ikerdcm/wulpus-pro_fpc/hw/wulpus_pro_fpc_board/wulpus_pro_acq_pcb/wulpus_pro_acq_pcb.kicad_pcb

## KiCad design hw/wulpus_pro_fpc_board/wulpus_pro_acq_pcb/wulpus_pro_acq_pcb.kicad_pcb (2026-04-16)

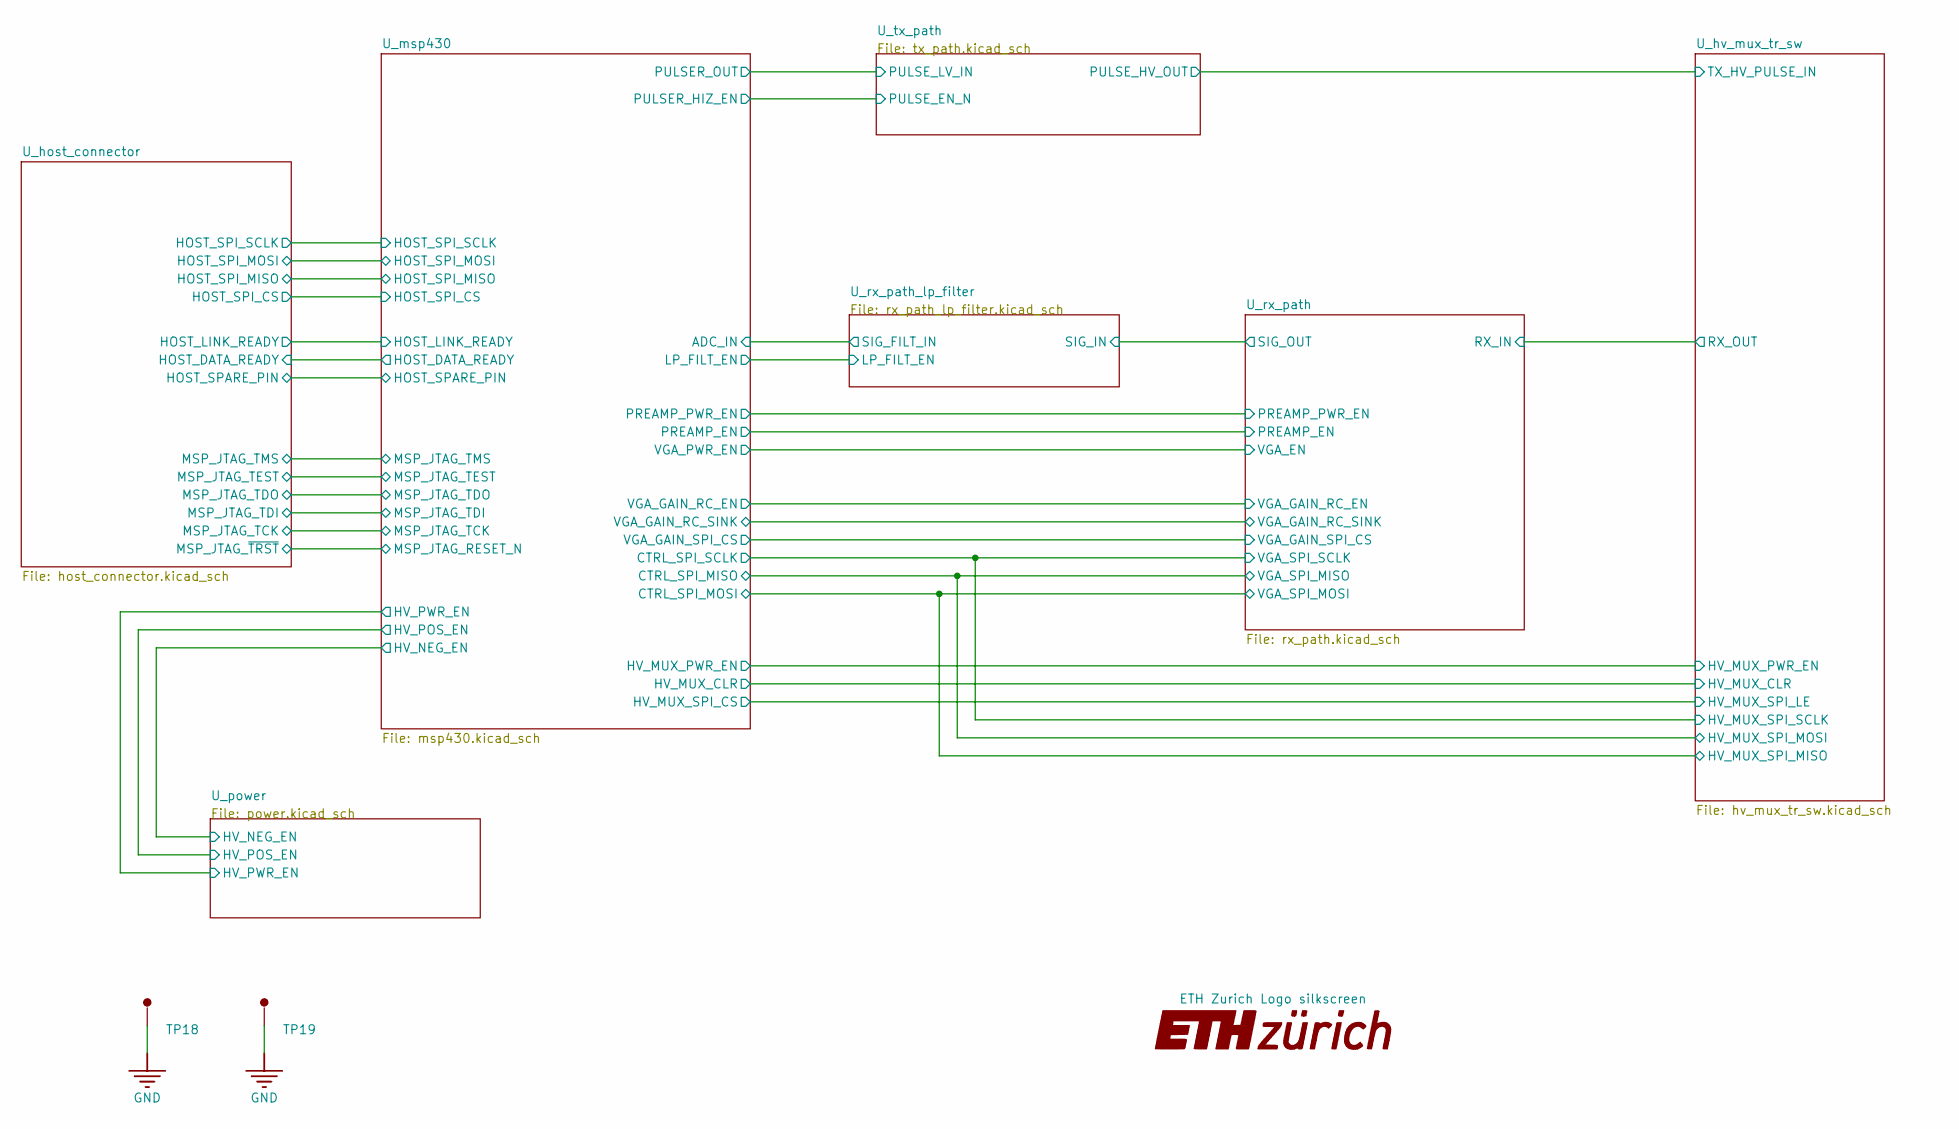
[picture p1: schematic wulpus_pro_acq_pcb.kicad_sch, WULPUS PRO Flex PCB]

Parts:
ART1: ETH Zurich Logo silkscreen; ETH_zurich_2mm
TP18, TP19: TP-SM-C-100; TestPoint_Pad_D1.0mm

Connections:
GND: TP18.1 (1_1), TP19.1 (1_1); also elsewhere on the board

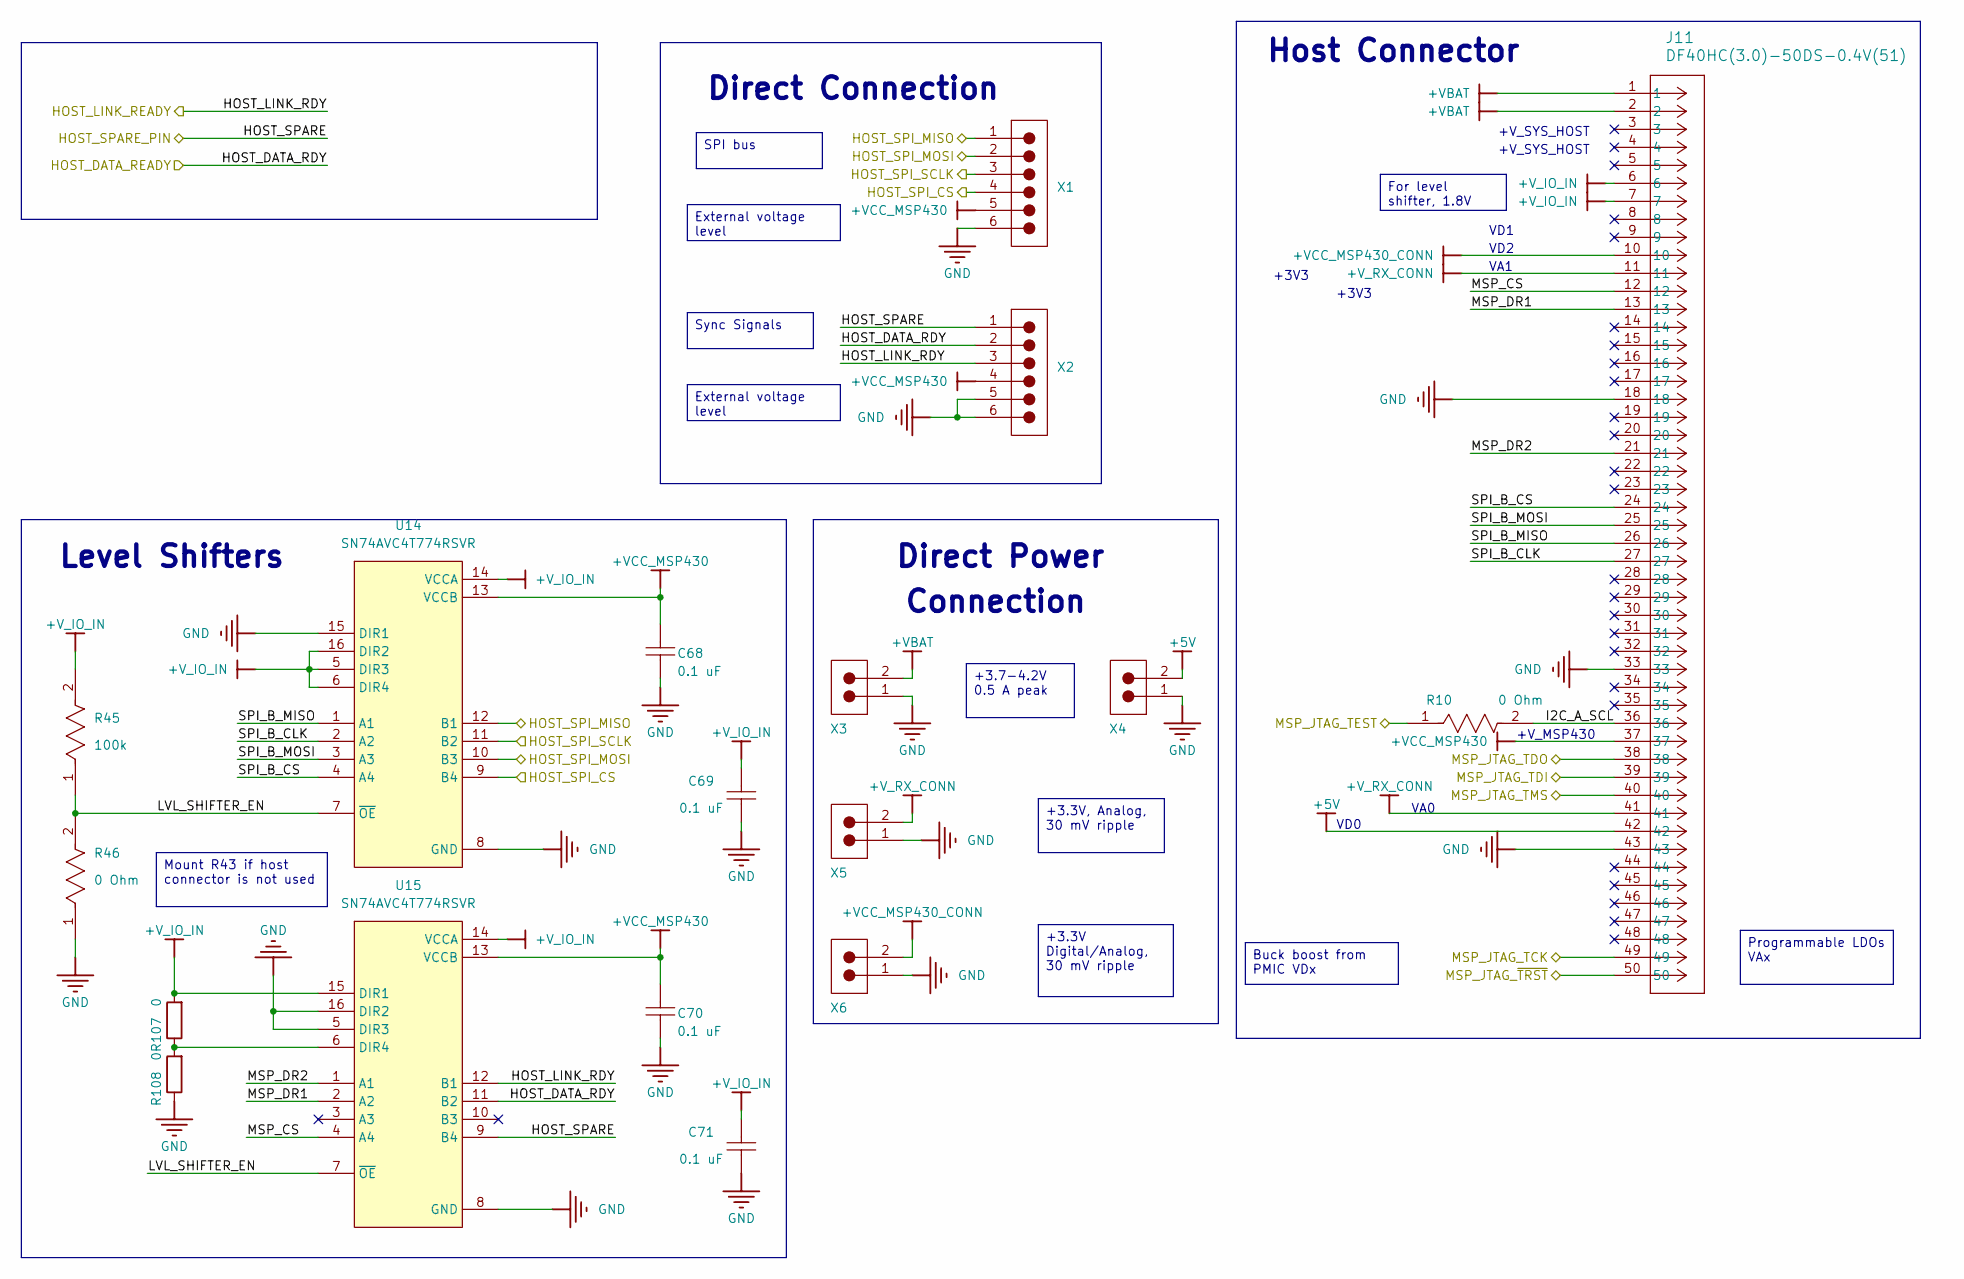
[picture p2: schematic host_connector.kicad_sch, WULPUS PRO]

Parts:
C68, C69, C70, C71: 0.1 uF; C_0402_1005Metric; PART NUMBER C0402C104K4RACTU
J11: DF40HC(3.0)-50DS-0.4V(51); CONN_DF40HC3.0-50DS-0.4V51_HIR; MPN DF40HC(3.0)-50DS-0.4V(51); LCSC C3652838
R10, R46: 0 Ohm; R_0402_1005Metric; TOLERANCE 5%; VOLTAGE RATING 50V; MPN CRCW04020000Z0ED
R45: 100k; R_0402_1005Metric; VOLTAGE RATING (DC) 50V; TOLERANCE 1%; MPN ERJ-2RKF1003X
R107, R108: 0; R_0402_1005Metric; Tolerance 5%; MPN ERJ-2GE0R00X; LCSC C17168
U14, U15: SN74AVC4T774RSVR; UQFN-16_1.8x2.6mm_P0.4mm; MPN SN74AVC4T774RSVR; DIGI-KEY_PART_NUMBER 296-24741-1-ND
X1, X2: 68000-106HLF; PinHeader_1x06_P2.54mm_Vertical; CURRENT RATING 3A; VOLTAGE RATING 1.5kV; MPN 68000-102HLF
X3, X4, X5, X6: 68000-102HLF; PinHeader_1x02_P2.54mm_Vertical; CURRENT RATING 3A; FLAMMABILITY RATING UL94 V-0; MANUFACTURER PART NUMBER 68000-102HLF

Connections:
+5V: J11.42, X4.2; also elsewhere on the board
+VBAT: J11.1, J11.2, X3.2; also elsewhere on the board
+VBAT_STM: C68.1, C70.1, J11.37, U14.13 (VCCB), U15.13 (VCCB), X1.5, X2.4; also elsewhere on the board
+VCC_MSP430_CONN: J11.10, X6.2; also elsewhere on the board
+V_IO_IN: C69.1, C71.1, J11.6, J11.7, R45.2, R107.2, U14.5 (DIR3), U14.6 (DIR4), U14.14 (VCCA), U14.16 (DIR2), U15.14 (VCCA), U15.15 (DIR1)
+V_RX_CONN: J11.11, J11.41, X5.2; also elsewhere on the board
/U_host_connector/HOST_DATA_RDY: U15.11 (B2), X2.2; also elsewhere on the board
/U_host_connector/HOST_LINK_RDY: U15.12 (B1), X2.3; also elsewhere on the board
/U_host_connector/HOST_SPARE: U15.9 (B4), X2.1; also elsewhere on the board
/U_host_connector/HOST_SPI_CS: U14.9 (B4), X1.4; also elsewhere on the board
/U_host_connector/HOST_SPI_MISO: U14.12 (B1), X1.1; also elsewhere on the board
/U_host_connector/HOST_SPI_MOSI: U14.10 (B3), X1.2; also elsewhere on the board
/U_host_connector/HOST_SPI_SCLK: U14.11 (B2), X1.3; also elsewhere on the board
/U_host_connector/I2C_A_SCL: J11.36, R10.2
/U_host_connector/LVL_SHIFTER_EN: R45.1, R46.2, U14.7 (~OE), U15.7 (~OE)
/U_host_connector/MSP_CS: J11.12, U15.4 (A4)
/U_host_connector/MSP_DR1: J11.13, U15.2 (A2)
/U_host_connector/MSP_DR2: J11.21, U15.1 (A1)
/U_host_connector/SPI_B_CLK: J11.27, U14.2 (A2)
/U_host_connector/SPI_B_CS: J11.24, U14.4 (A4)
/U_host_connector/SPI_B_MISO: J11.26, U14.1 (A1)
/U_host_connector/SPI_B_MOSI: J11.25, U14.3 (A3)
/U_msp430/MSP_JTAG_RESET_N: J11.50; also elsewhere on the board
/U_msp430/MSP_JTAG_TCK: J11.49; also elsewhere on the board
/U_msp430/MSP_JTAG_TDI: J11.39; also elsewhere on the board
/U_msp430/MSP_JTAG_TDO: J11.38; also elsewhere on the board
/U_msp430/MSP_JTAG_TEST: R10.1; also elsewhere on the board
/U_msp430/MSP_JTAG_TMS: J11.40; also elsewhere on the board
GND: C68.2, C69.2, C70.2, C71.2, J11.18, J11.33, J11.43, R46.1, R108.1, U14.8 (GND), U14.15 (DIR1), U15.5 (DIR3), U15.8 (GND), U15.16 (DIR2), X1.6, X2.5, X2.6, X3.1, X4.1, X5.1, X6.1; also elsewhere on the board
unnamed: R107.1, R108.2, U15.6 (DIR4)

Notes on the sheet:
+V_SYS_HOST
Connection
Direct Connection
Direct Power
VD1
+V_MSP430
+3V3
Level Shifters
VA1
VD0
VD2
Host Connector
VA0
+3.3V Digital/Analog, 30 mV ripple
Mount R43 if host connector is not used
+3.3V, Analog, 30 mV ripple
Sync Signals
SPI bus
+3.7-4.2V 0.5 A peak
External voltage level
For level shifter, 1.8V
Programmable LDOs VAx
Buck boost from PMIC VDx

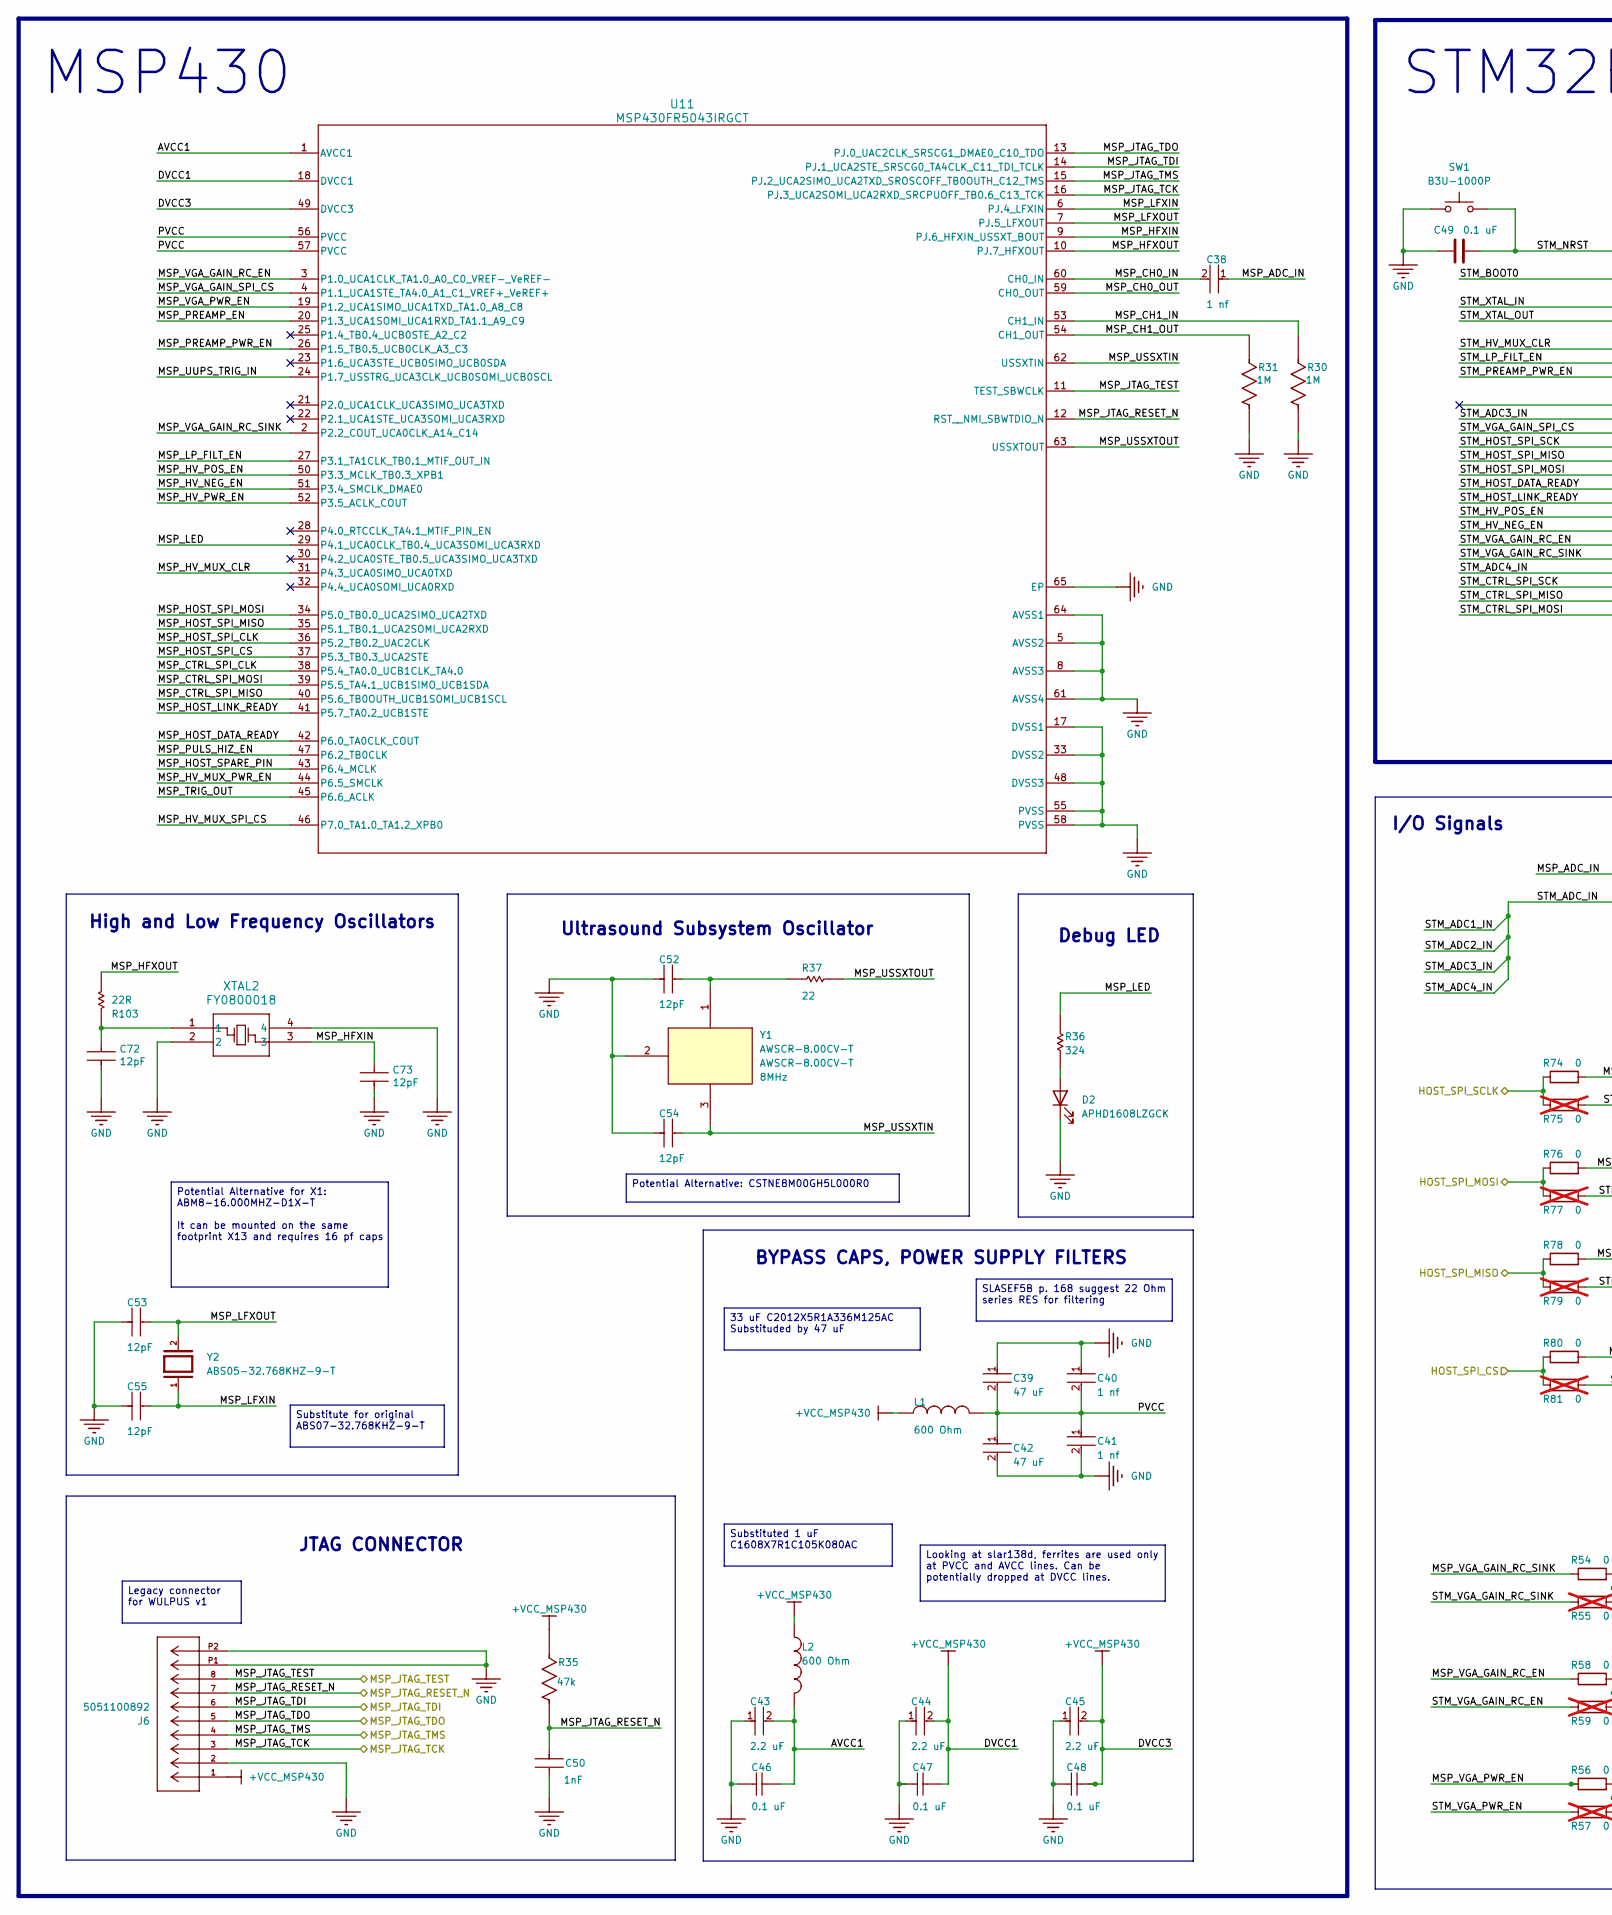
[picture p3: schematic msp430.kicad_sch, WULPUS PRO, part in row 1, column 1]

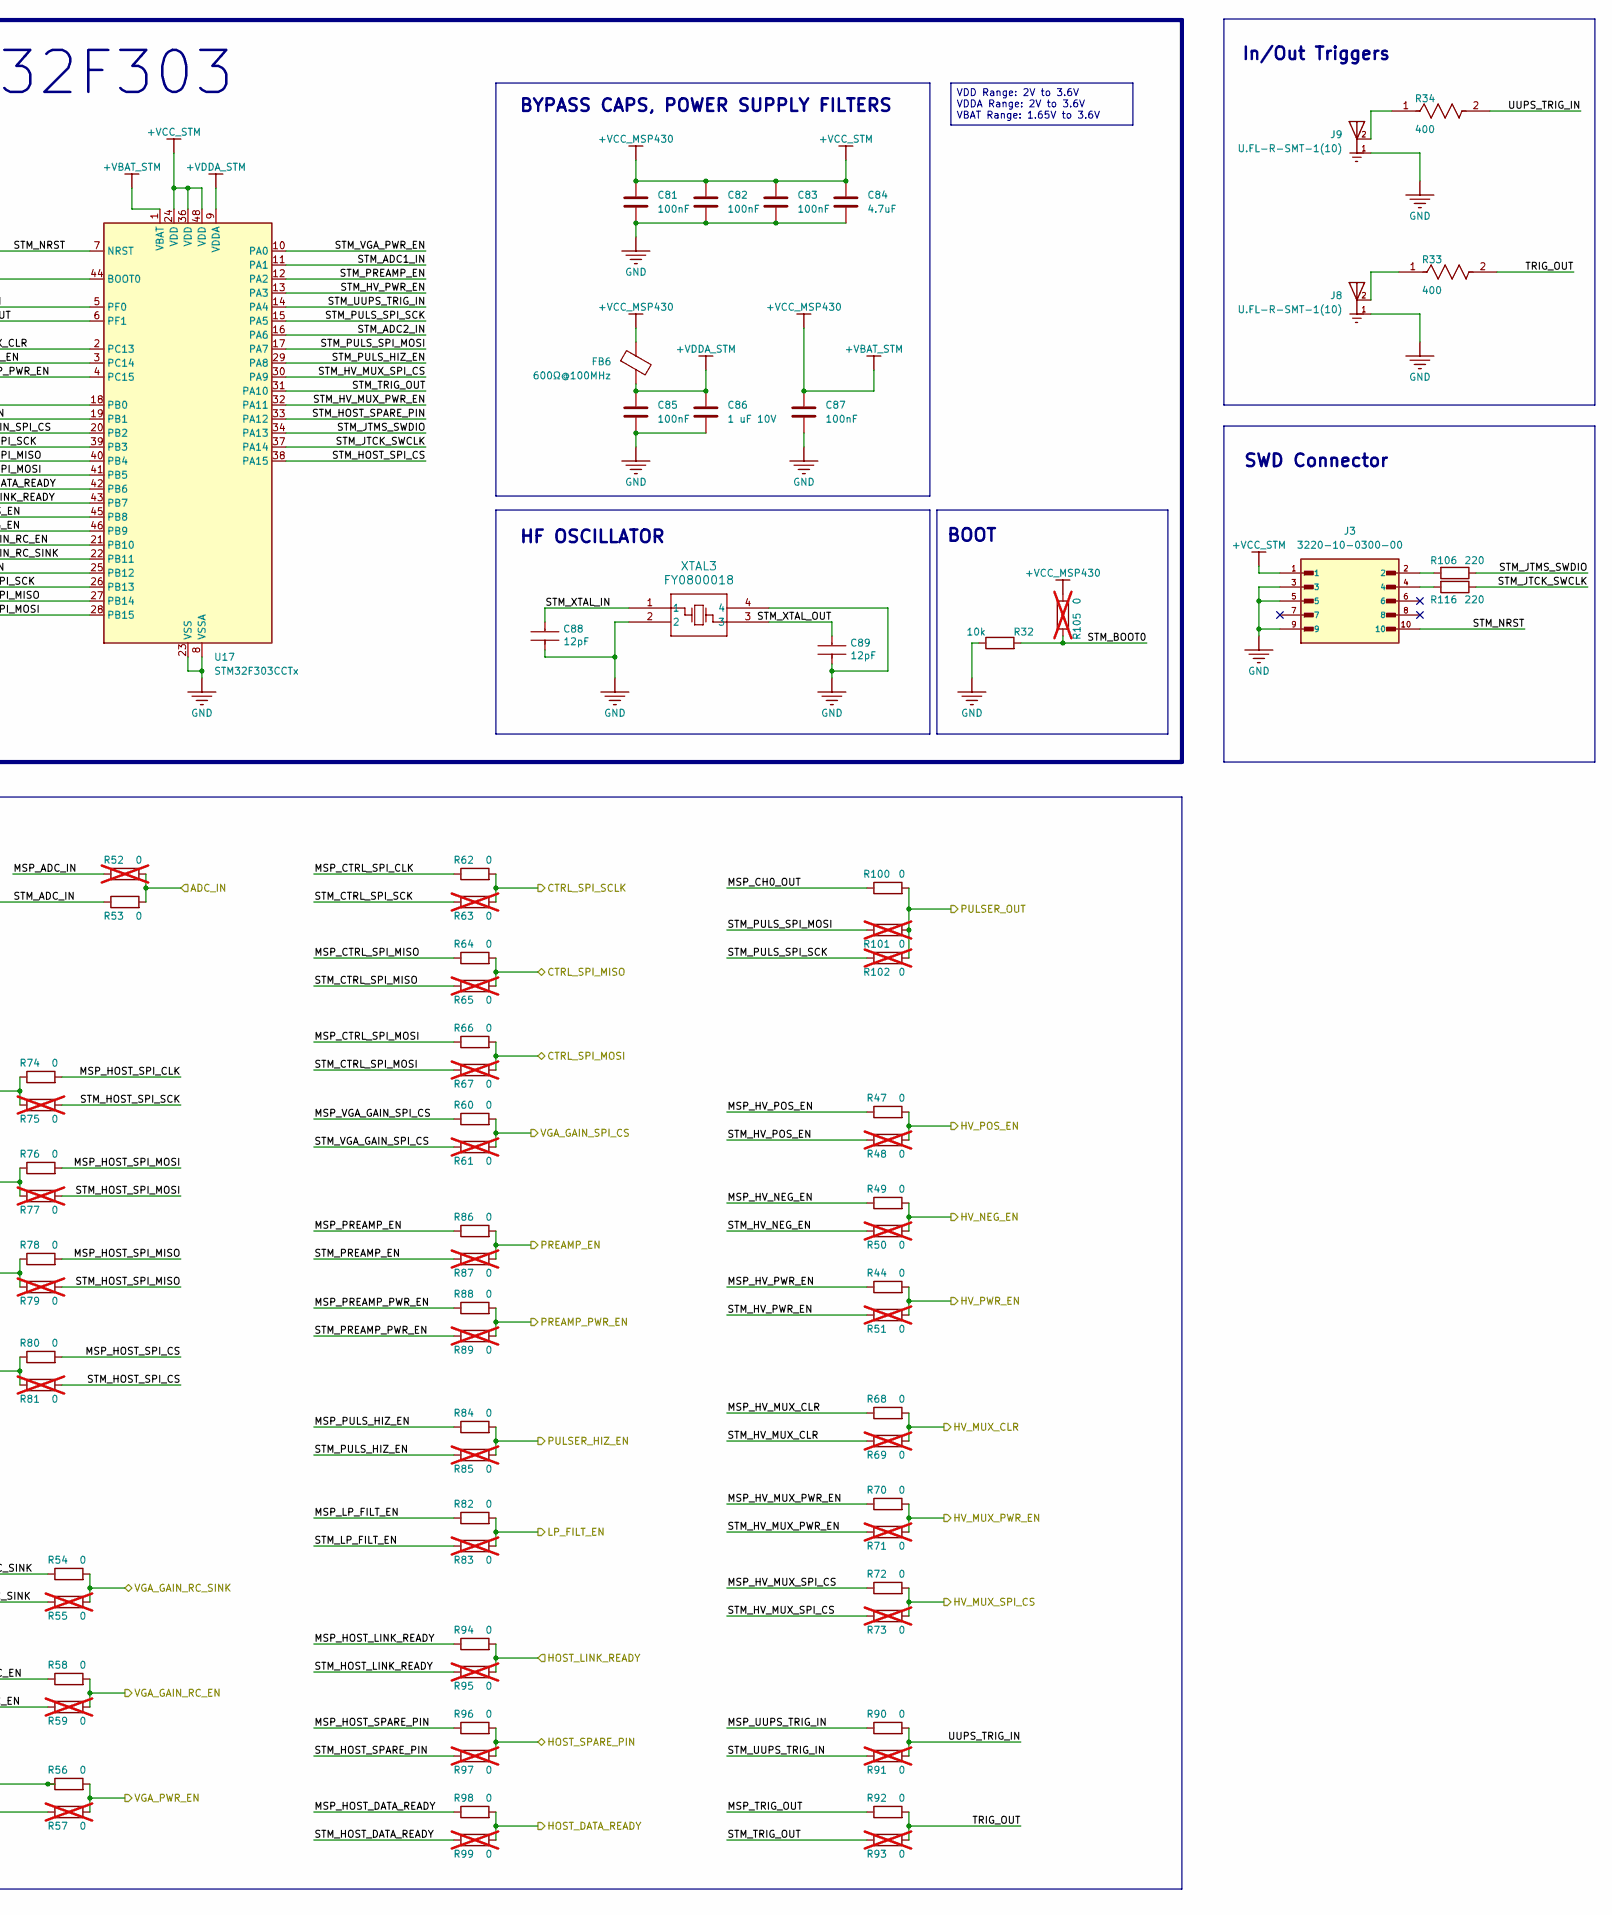
[picture p4: schematic msp430.kicad_sch, WULPUS PRO, part in row 1, column 2]

Parts:
C38, C40, C41: 1 nf; C_0402_1005Metric; TOLERANCE 5%; VOLTAGE RATING 50V; PART NUMBER GRM1555C1H102JA01D
C39, C42: 47 uF; C_0603_1608Metric; TOLERANCE 20%; VOLTAGE RATING (DC) 6.3V; PART NUMBER GRM188R60J476ME01D
C43, C44, C45: 2.2 uF; C_0402_1005Metric; VOLTAGE RATING 10V; VOLTAGE RATING (DC) 10V; PART NUMBER C1005X7S1A225K050BC
C46, C47, C48: 0.1 uF; C_0402_1005Metric; PART NUMBER C0402C104K4RACTU
C49: 0.1 uF; C_0402_1005Metric; MPN C0402C104K4RACTU
C50: 1000 pF 50V; C_0402_1005Metric; TOLERANCE 5%; VOLTAGE RATING 50V; PART NUMBER GRM1555C1H102JA01D
C52, C53, C54, C55, C72, C73, C88, C89: 12 pF 50V; C_0402_1005Metric; TOLERANCE 2%; VOLTAGE RATING 50V; PART NUMBER GJM1555C1H120GB01D
C81, C82, C83, C85, C87: 100nF; C_0402_1005Metric; MPN C0402C104K4RACTU
C84: 4.7uF; C_0402_1005Metric; MPN MLASL105BB5475MFNB33
C86: 1 uF 10V; C_0402_1005Metric; MPN GRM155Z71A105KE01D
D2: APHD1608LZGCK; LED_0603_1608Metric; MPN APHD1608LZGCK
FB6: 600Ω@100MHz; L_0603_1608Metric; MPN BLM18AG601SZ1; LCSC C710353
J3: 3220-10-0300-00; CNC_3220-10-0300-00; PARTREV D; LCSC C7501307
J6: 5051100892; CON_5051100892_MOL; MPN 5051100892; LCSC C5902847
J8, J9: U.FL-R-SMT-1(10); HRS_U.FL-R-SMT-1_10_; MPN U.FL-R-SMT-1(10); DigiKey_Part_Number H11891CT-ND
L1, L2: 742792040; L_0805_2012Metric_Pad1.05x1.20mm_HandSolder; MPN 742792040
R30, R31: CRCW04021M00FKED; R_0402_1005Metric; POWER RATING 63mW; VOLTAGE RATING (DC) 50V; MPN CRCW04021M00FKED
R32: 10k; R_0402_1005Metric
R33, R34: 400; R_0402_1005Metric; TOLERANCE 1%; VOLTAGE RATING 50V; MPN CRCW04021R00FKEDC
R35: CRCW040247K0FKED; R_0402_1005Metric; TOLERANCE 1%; VOLTAGE RATING (DC) 50V; MPN CRCW040247K0FKED
R36: 324R; R_0402_1005Metric; PART NUMBER CPF0402B324RE1
R37, R103: 22R; R_0402_1005Metric; PART NUMBER RC0402JR-0722RL
R44, R47, R49, R53, R54, R56, R58, R60, R62, R64, R66, R68, R70, R72, R74, R76, R78, R80, R82, R84, R86, R88, R90, R92, R94, R96, R98, R100: 0; R_0402_1005Metric; Tolerance 5%; MPN ERJ-2GE0R00X; LCSC C17168
R48, R50, R51, R52, R55, R57, R59, R61, R63, R65, R67, R69, R71, R73, R75, R77, R79, R81, R83, R85, R87, R89, R91, R93, R95, R97, R99, R101, R102, R105: 0; R_0402_1005Metric; Tolerance 5%; MPN ERJ-2GE0R00X; LCSC C17168; not fitted
R106, R116: 220; R_0402_1005Metric; Tolerance 1%; MPN ERJ-2RKF2200X; LCSC C413071
SW1: Button Switch SPST-No; SW_SPST_B3U-1000P; MPN B3U-1000P; LCSC C231329
U11: MSP430FR5043IRGCT; VQFN-64-1EP_9x9mm_P0.5mm_EP5.4x5.4mm; MPN MSP430FR5043IRGCT
U17: STM32F303CCTx; LQFP-48_7x7mm_P0.5mm; MPN STM32F303CCTx
XTAL2, XTAL3: FY0800018; 4xtal- 1-3xtal 2-4NC_DIO; MPN FY0800018; LCSC C6951614
Y1: AWSCR-8.00CV-T; AWSCR-8.00CV-T_ABR; MPN AWSCR-8.00CV-T; LCSC C2650764
Y2: ABS05-32.768KHZ-9-T; XTAL_ABS05-32.768KHZ-9-T; PARTREV 11/3/2021; DigiKey_Part_Number 535-ABS05-32.768KHZ-9-TCT-ND

Connections:
+VBAT_STM: C44.2, C45.2, C47.1, C48.1, C81.1, C82.1, C83.1, C84.1, C87.1, FB6.1, J3.1, J6.1, L1.1, L2.1, R35.1, R105.2, U11.18 (DVCC1), U11.49 (DVCC3), U17.1 (VBAT), U17.24 (VDD), U17.36 (VDD), U17.48 (VDD); also elsewhere on the board
+VDDA_STM: C85.1, C86.1, FB6.2, U17.9 (VDDA)
/U_host_connector/HOST_DATA_RDY: R98.2, R99.2; also elsewhere on the board
/U_host_connector/HOST_LINK_RDY: R94.2, R95.2; also elsewhere on the board
/U_host_connector/HOST_SPARE: R96.2, R97.2; also elsewhere on the board
/U_host_connector/HOST_SPI_CS: R80.1, R81.1; also elsewhere on the board
/U_host_connector/HOST_SPI_MISO: R78.1, R79.1; also elsewhere on the board
/U_host_connector/HOST_SPI_MOSI: R76.1, R77.1; also elsewhere on the board
/U_host_connector/HOST_SPI_SCLK: R74.1, R75.1; also elsewhere on the board
/U_hv_mux_tr_sw/HV_MUX_CLR: R68.2, R69.2; also elsewhere on the board
/U_hv_mux_tr_sw/HV_MUX_PWR_EN: R70.2, R71.2; also elsewhere on the board
/U_hv_mux_tr_sw/HV_MUX_SPI_LE: R72.2, R73.2; also elsewhere on the board
/U_hv_mux_tr_sw/HV_MUX_SPI_MISO: R66.2, R67.2; also elsewhere on the board
/U_hv_mux_tr_sw/HV_MUX_SPI_MOSI: R64.2, R65.2; also elsewhere on the board
/U_hv_mux_tr_sw/HV_MUX_SPI_SCLK: R62.2, R63.2; also elsewhere on the board
/U_msp430/ADC_IN: R52.2, R53.2; also elsewhere on the board
/U_msp430/AVCC1: C43.2, C46.1, L2.2, U11.1 (AVCC1)
/U_msp430/HV_PWR_EN: R44.2, R51.2; also elsewhere on the board
/U_msp430/MSP_ADC_IN: C38.1, R52.1
/U_msp430/MSP_CH0_IN: C38.2, U11.60 (CH0_IN)
/U_msp430/MSP_CH0_OUT: R100.1, U11.59 (CH0_OUT)
/U_msp430/MSP_CH1_IN: R30.1, U11.53 (CH1_IN)
/U_msp430/MSP_CH1_OUT: R31.1, U11.54 (CH1_OUT)
/U_msp430/MSP_CTRL_SPI_CLK: R62.1, U11.38 (P5.4_TA0.0_UCB1CLK_TA4.0)
/U_msp430/MSP_CTRL_SPI_MISO: R64.1, U11.40 (P5.6_TB0OUTH_UCB1SOMI_UCB1SCL)
/U_msp430/MSP_CTRL_SPI_MOSI: R66.1, U11.39 (P5.5_TA4.1_UCB1SIMO_UCB1SDA)
/U_msp430/MSP_HFXIN: C73.2, U11.9 (PJ.6_HFXIN_USSXT_BOUT), XTAL2.3
/U_msp430/MSP_HFXOUT: R103.2, U11.10 (PJ.7_HFXOUT)
/U_msp430/MSP_HOST_DATA_READY: R98.1, U11.42 (P6.0_TA0CLK_COUT)
/U_msp430/MSP_HOST_LINK_READY: R94.1, U11.41 (P5.7_TA0.2_UCB1STE)
/U_msp430/MSP_HOST_SPARE_PIN: R96.1, U11.43 (P6.4_MCLK)
/U_msp430/MSP_HOST_SPI_CLK: R74.2, U11.36 (P5.2_TB0.2_UAC2CLK)
/U_msp430/MSP_HOST_SPI_CS: R80.2, U11.37 (P5.3_TB0.3_UCA2STE)
/U_msp430/MSP_HOST_SPI_MISO: R78.2, U11.35 (P5.1_TB0.1_UCA2SOMI_UCA2RXD)
/U_msp430/MSP_HOST_SPI_MOSI: R76.2, U11.34 (P5.0_TB0.0_UCA2SIMO_UCA2TXD)
/U_msp430/MSP_HV_MUX_CLR: R68.1, U11.31 (P4.3_UCA0SIMO_UCA0TXD)
/U_msp430/MSP_HV_MUX_PWR_EN: R70.1, U11.44 (P6.5_SMCLK)
/U_msp430/MSP_HV_MUX_SPI_CS: R72.1, U11.46 (P7.0_TA1.0_TA1.2_XPB0)
/U_msp430/MSP_HV_NEG_EN: R49.1, U11.51 (P3.4_SMCLK_DMAE0)
/U_msp430/MSP_HV_POS_EN: R47.1, U11.50 (P3.3_MCLK_TB0.3_XPB1)
/U_msp430/MSP_HV_PWR_EN: R44.1, U11.52 (P3.5_ACLK_COUT)
/U_msp430/MSP_JTAG_RESET_N: C50.1, J6.7, R35.2, U11.12 (RST__NMI_SBWTDIO_N); also elsewhere on the board
/U_msp430/MSP_JTAG_TCK: J6.3, U11.16 (PJ.3_UCA2SOMI_UCA2RXD_SRCPUOFF_TB0.6_C1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); also elsewhere on the board
/U_msp430/MSP_JTAG_TDI: J6.6, U11.14 (PJ.1_UCA2STE_SRSCG0_TA4CLK_C11_TDI_TCLK); also elsewhere on the board
/U_msp430/MSP_JTAG_TDO: J6.5, U11.13 (PJ.0_UAC2CLK_SRSCG1_DMAE0_C10_TDO); also elsewhere on the board
/U_msp430/MSP_JTAG_TEST: J6.8, U11.11 (TEST_SBWCLK); also elsewhere on the board
/U_msp430/MSP_JTAG_TMS: J6.4, U11.15 (PJ.2_UCA2SIMO_UCA2TXD_SROSCOFF_TB0OUTH_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); also elsewhere on the board
/U_msp430/MSP_LED: R36.1, U11.29 (P4.1_UCA0CLK_TB0.4_UCA3SOMI_UCA3RXD)
/U_msp430/MSP_LFXIN: C55.2, U11.6 (PJ.4_LFXIN), Y2.1
/U_msp430/MSP_LFXOUT: C53.2, U11.7 (PJ.5_LFXOUT), Y2.2
/U_msp430/MSP_LP_FILT_EN: R82.1, U11.27 (P3.1_TA1CLK_TB0.1_MTIF_OUT_IN)
/U_msp430/MSP_PREAMP_EN: R86.1, U11.20 (P1.3_UCA1SOMI_UCA1RXD_TA1.1_A9_C9)
/U_msp430/MSP_PREAMP_PWR_EN: R88.1, U11.26 (P1.5_TB0.5_UCB0CLK_A3_C3)
/U_msp430/MSP_PULS_HIZ_EN: R84.1, U11.47 (P6.2_TB0CLK)
/U_msp430/MSP_TRIG_OUT: R92.1, U11.45 (P6.6_ACLK)
/U_msp430/MSP_USSXTIN: C54.2, U11.62 (USSXTIN), Y1.3
/U_msp430/MSP_USSXTOUT: R37.2, U11.63 (USSXTOUT)
/U_msp430/MSP_UUPS_TRIG_IN: R90.1, U11.24 (P1.7_USSTRG_UCA3CLK_UCB0SOMI_UCB0SCL)
/U_msp430/MSP_VGA_GAIN_RC_EN: R58.1, U11.3 (P1.0_UCA1CLK_TA1.0_A0_C0_VREF-_VeREF-)
/U_msp430/MSP_VGA_GAIN_RC_SINK: R54.1, U11.2 (P2.2_COUT_UCA0CLK_A14_C14)
/U_msp430/MSP_VGA_GAIN_SPI_CS: R60.1, U11.4 (P1.1_UCA1STE_TA4.0_A1_C1_VREF+_VeREF+)
/U_msp430/MSP_VGA_PWR_EN: R56.1, U11.19 (P1.2_UCA1SIMO_UCA1TXD_TA1.0_A8_C8)
/U_msp430/PREAMP_PWR_EN: R88.2, R89.2; also elsewhere on the board
/U_msp430/PULSER_HIZ_EN: R84.2, R85.2; also elsewhere on the board
/U_msp430/PULSER_OUT: R100.2, R101.2, R102.2; also elsewhere on the board
/U_msp430/PVCC: C39.2, C40.2, C41.1, C42.1, L1.2, U11.56 (PVCC), U11.57 (PVCC)
/U_msp430/STM_BOOT0: R32.2, R105.1, U17.44 (BOOT0)
/U_msp430/STM_CTRL_SPI_MISO: R65.1, U17.27 (PB14)
/U_msp430/STM_CTRL_SPI_MOSI: R67.1, U17.28 (PB15)
/U_msp430/STM_CTRL_SPI_SCK: R63.1, U17.26 (PB13)
/U_msp430/STM_HOST_DATA_READY: R99.1, U17.42 (PB6)
/U_msp430/STM_HOST_LINK_READY: R95.1, U17.43 (PB7)
/U_msp430/STM_HOST_SPARE_PIN: R97.1, U17.33 (PA12)
/U_msp430/STM_HOST_SPI_CS: R81.2, U17.38 (PA15)
/U_msp430/STM_HOST_SPI_MISO: R79.2, U17.40 (PB4)
/U_msp430/STM_HOST_SPI_MOSI: R77.2, U17.41 (PB5)
/U_msp430/STM_HOST_SPI_SCK: R75.2, U17.39 (PB3)
/U_msp430/STM_HV_MUX_CLR: R69.1, U17.2 (PC13)
/U_msp430/STM_HV_MUX_PWR_EN: R71.1, U17.32 (PA11)
/U_msp430/STM_HV_MUX_SPI_CS: R73.1, U17.30 (PA9)
/U_msp430/STM_HV_NEG_EN: R50.1, U17.46 (PB9)
/U_msp430/STM_HV_POS_EN: R48.1, U17.45 (PB8)
/U_msp430/STM_HV_PWR_EN: R51.1, U17.13 (PA3)
/U_msp430/STM_JTCK_SWCLK: R116.1, U17.37 (PA14)
/U_msp430/STM_JTMS_SWDIO: R106.1, U17.34 (PA13)
/U_msp430/STM_LP_FILT_EN: R83.1, U17.3 (PC14)
/U_msp430/STM_NRST: C49.1, J3.10, SW1.2, U17.7 (NRST)
/U_msp430/STM_PREAMP_EN: R87.1, U17.12 (PA2)
/U_msp430/STM_PREAMP_PWR_EN: R89.1, U17.4 (PC15)
/U_msp430/STM_PULS_HIZ_EN: R85.1, U17.29 (PA8)
/U_msp430/STM_PULS_SPI_MOSI: R101.1, U17.17 (PA7)
/U_msp430/STM_PULS_SPI_SCK: R102.1, U17.15 (PA5)
/U_msp430/STM_TRIG_OUT: R93.1, U17.31 (PA10)
/U_msp430/STM_UUPS_TRIG_IN: R91.1, U17.14 (PA4)
/U_msp430/STM_VGA_GAIN_RC_EN: R59.1, U17.21 (PB10)
/U_msp430/STM_VGA_GAIN_RC_SINK: R55.1, U17.22 (PB11)
/U_msp430/STM_VGA_GAIN_SPI_CS: R61.1, U17.20 (PB2)
/U_msp430/STM_VGA_PWR_EN: R57.1, U17.10 (PA0)
/U_msp430/STM_XTAL_IN: C88.2, U17.5 (PF0), XTAL3.1
/U_msp430/STM_XTAL_OUT: C89.2, U17.6 (PF1), XTAL3.3
/U_msp430/TRIG_OUT: R33.2, R92.2, R93.2
/U_msp430/UUPS_TRIG_IN: R34.2, R90.2, R91.2
/U_msp430/VGA_GAIN_RC_EN: R58.2, R59.2; also elsewhere on the board
/U_msp430/VGA_GAIN_RC_SINK: R54.2, R55.2; also elsewhere on the board
/U_msp430/VGA_GAIN_SPI_CS: R60.2, R61.2; also elsewhere on the board
/U_msp430/VGA_PWR_EN: R56.2, R57.2; also elsewhere on the board
/U_power/HV_EN1: R47.2, R48.2; also elsewhere on the board
/U_power/HV_EN2: R49.2, R50.2; also elsewhere on the board
/U_rx_path/PREAMP_SHDN_N: R86.2, R87.2; also elsewhere on the board
/U_rx_path_lp_filter/FILTER_SHDN_N: R82.2, R83.2; also elsewhere on the board
GND: C39.1, C40.1, C41.2, C42.2, C43.1, C44.1, C45.1, C46.2, C47.2, C48.2, C49.2, C50.2, C52.1, C53.1, C54.1, C55.1, C72.1, C73.1, C81.2, C82.2, C83.2, C84.2, C85.2, C86.2, C87.2, C88.1, C89.1, D2.1 (K), J3.3, J3.5, J3.9, J6.2, J6.P1, J6.P2, J8.1, J8.3, J9.1, J9.3, R30.2, R31.2, R32.1, SW1.1, U11.5 (AVSS2), U11.8 (AVSS3), U11.17 (DVSS1), U11.33 (DVSS2), U11.48 (DVSS3), U11.55 (PVSS), U11.58 (PVSS), U11.61 (AVSS4), U11.64 (AVSS1), U11.65 (EP), U17.8 (VSSA), U17.23 (VSS), U17.35 (VSS), U17.47 (VSS), XTAL2.2, XTAL2.4, XTAL3.2, XTAL3.4, Y1.2; also elsewhere on the board
unnamed: C52.2, R37.1, Y1.1
unnamed: C72.2, R103.1, XTAL2.1
unnamed: D2.2 (A), R36.2
unnamed: J3.2, R106.2
unnamed: J3.4, R116.2
unnamed: J8.2, R33.1
unnamed: J9.2, R34.1

Notes on the sheet:
High and Low Frequency Oscillators
BYPASS CAPS, POWER SUPPLY FILTERS
Debug LED
HF OSCILLATOR
MSP430
BOOT
SWD Connector
In/Out Triggers
STM32F303
JTAG CONNECTOR
Ultrasound Subsystem Oscillator
I/O Signals
VDD Range: 2V to 3.6V VDDA Range: 2V to 3.6V VBAT Range: 1.65V to 3.6V
Looking at slar138d, ferrites are used only at PVCC and AVCC lines. Can be potentially dropped at DVCC lines.
Substituted 1 uF C1608X7R1C105K080AC
33 uF C2012X5R1A336M125AC Substituded by 47 uF
SLASEF5B p. 168 suggest 22 Ohm series RES for filtering
Substitute for original ABS07-32.768KHZ-9-T
Potential Alternative for X1: ABM8-16.000MHZ-D1X-T It can be mounted on the same footprint X13 and requires 16 pf caps
Legacy connector for WULPUS v1
Potential Alternative: CSTNE8M00GH5L000R0
