ikerdcm/wulpus-pro_fpc/hw/wulpus_pro_fpc_board/wulpus_pro_acq_pcb/wulpus_pro_acq_pcb.kicad_pcb

## KiCad design hw/wulpus_pro_fpc_board/wulpus_pro_acq_pcb/wulpus_pro_acq_pcb.kicad_pcb (continued)

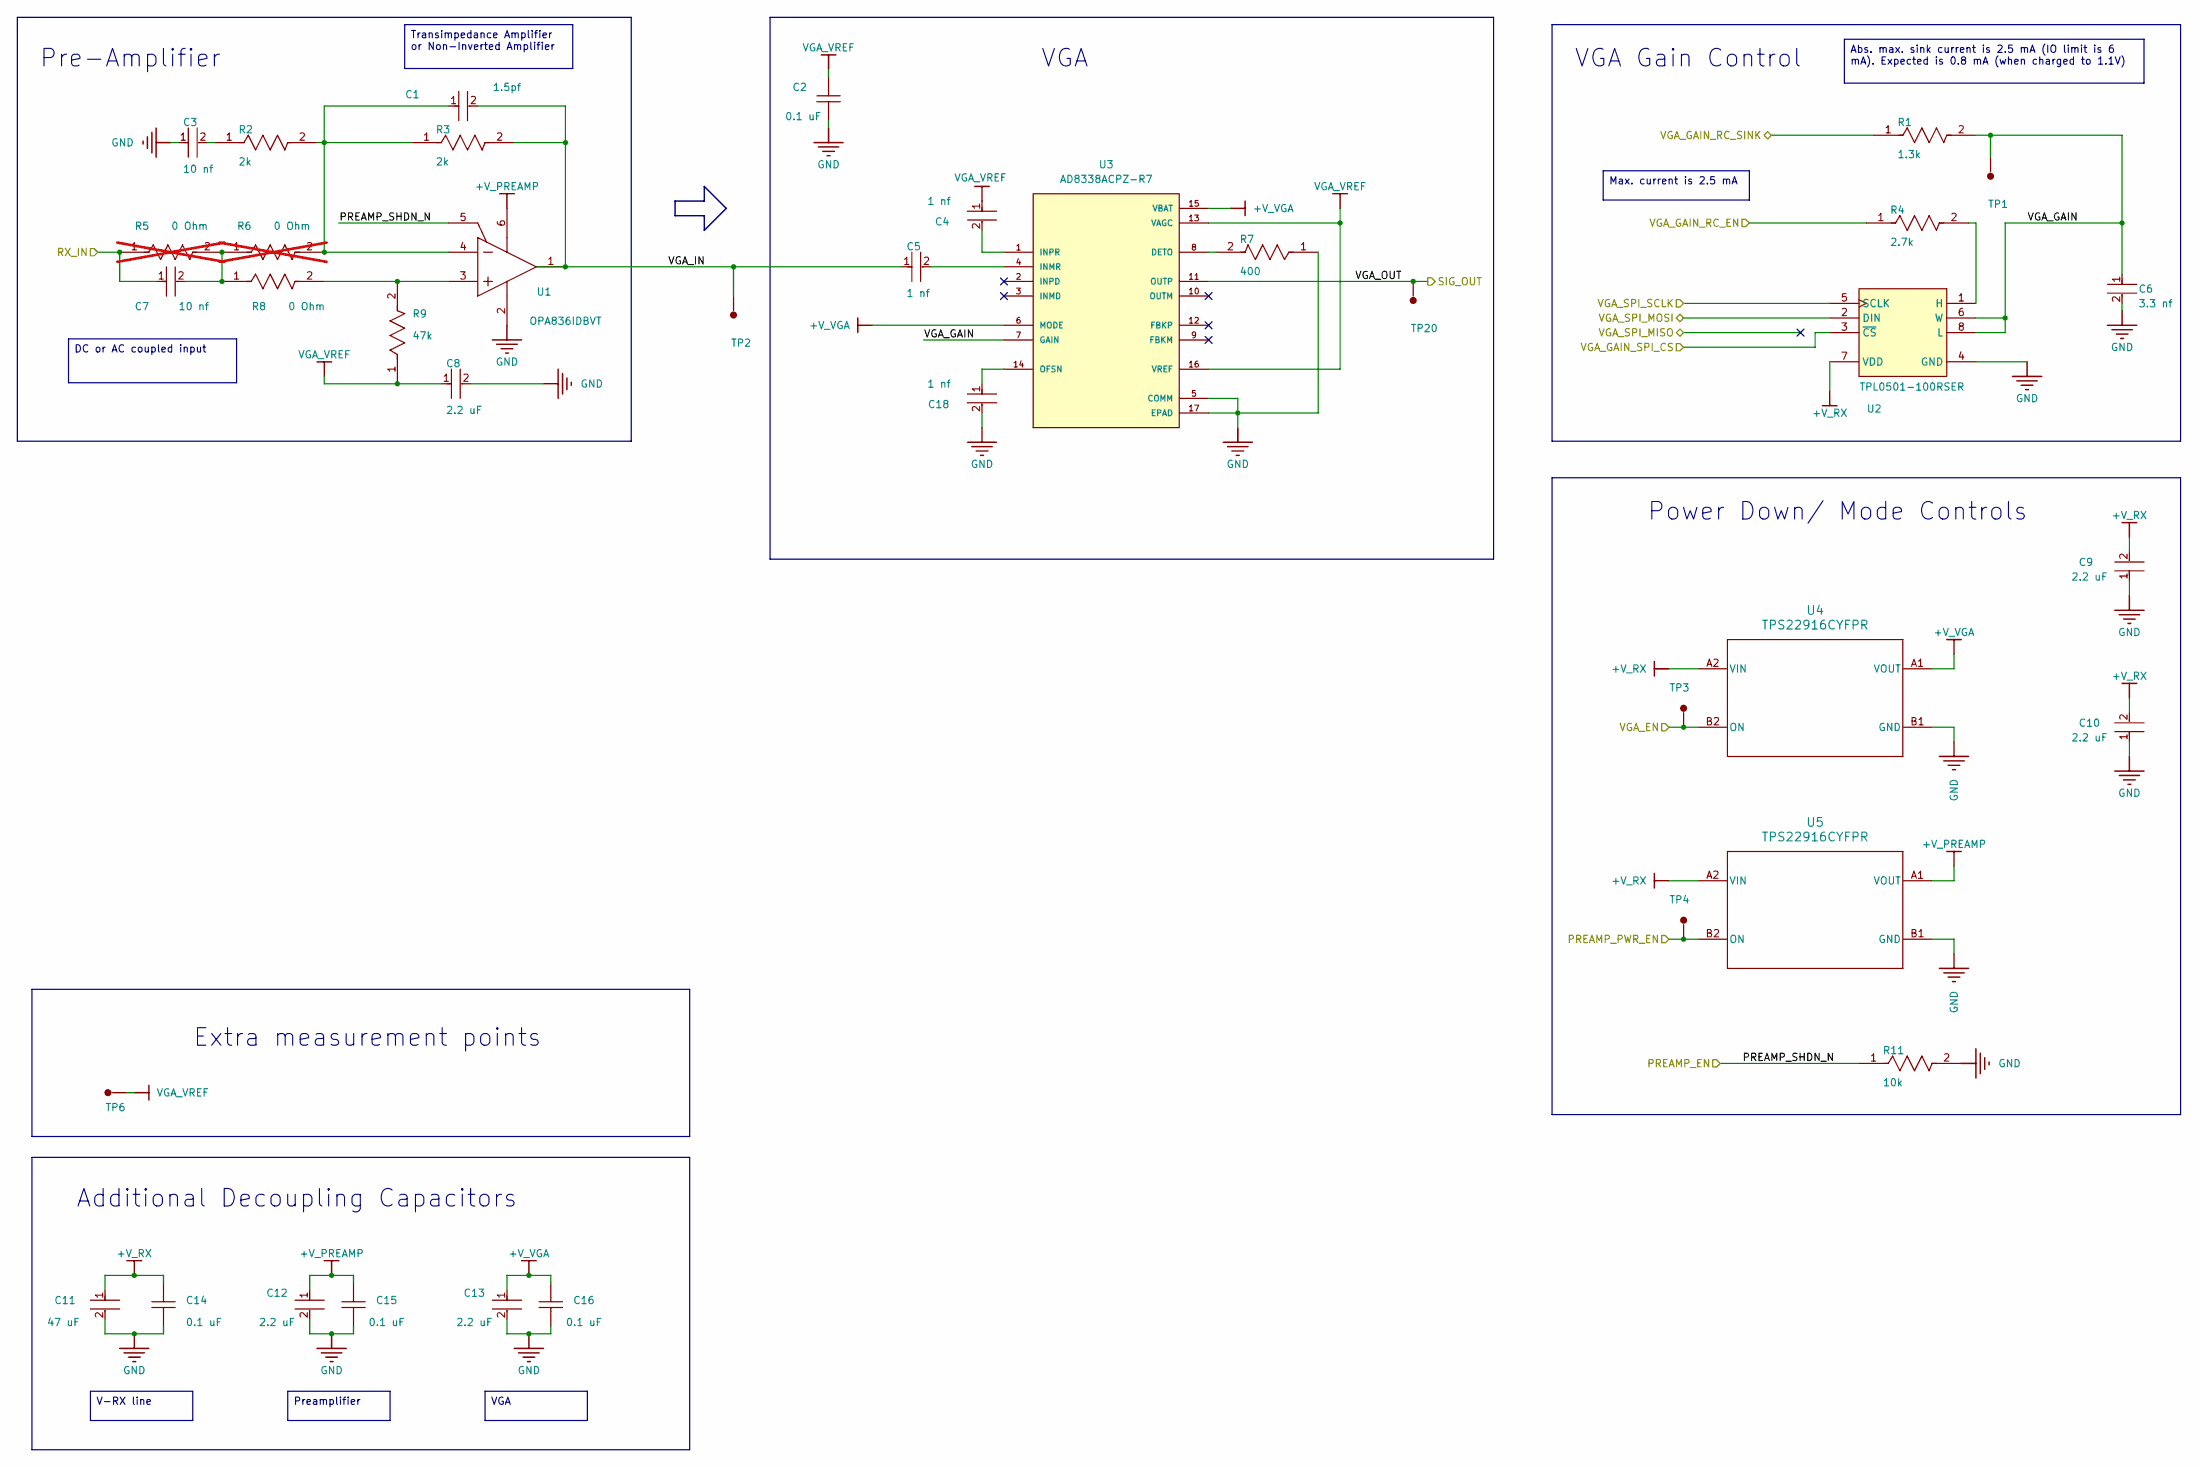
[picture p5: schematic rx_path.kicad_sch, WULPUS PRO]

Parts:
C1: 1.5pf; C_0402_1005Metric; VOLTAGE RATING 50V; VOLTAGE RATING (DC) 50V; PART NUMBER GJM1555C1H1R5BB01D
C2, C14, C15, C16: 0.1 uF; C_0402_1005Metric; PART NUMBER C0402C104K4RACTU
C3, C7: 10 nf; C_0402_1005Metric; VOLTAGE 10V; VOLTAGE RATING (DC) 10V; PART NUMBER GRM033R71A103KA01D
C4, C5, C18: 1 nf; C_0402_1005Metric; TOLERANCE 5%; VOLTAGE RATING 50V; PART NUMBER GRM1555C1H102JA01D
C6: 3.3 nf; C_0402_1005Metric; VOLTAGE RATING 50V; TOLERANCE 5%; PART NUMBER 04025C332JAT2A
C8, C9, C10, C12, C13: 2.2 uF; C_0402_1005Metric; VOLTAGE RATING 10V; VOLTAGE RATING (DC) 10V; PART NUMBER C1005X7S1A225K050BC
C11: 47 uF; C_0603_1608Metric; TOLERANCE 20%; VOLTAGE RATING (DC) 6.3V; PART NUMBER GRM188R60J476ME01D
R1: 1.3k; R_0402_1005Metric; TOLERANCE 5%; VOLTAGE RATING (DC) 50V; MPN CRCW04021K30JNED
R2, R3: 2k; R_0402_1005Metric; WORKING VOLTAGE 50V; POWER RATING 100mW; MPN ERJ-2RKF2001X
R4: 2.7k; R_0402_1005Metric; TOLERANCE 1%; MPN MCS04020C2701FE000
R5, R6: 0 Ohm; R_0402_1005Metric; TOLERANCE 5%; VOLTAGE RATING 50V; MPN CRCW04020000Z0ED; not fitted
R7: 400; R_0402_1005Metric; TOLERANCE 1%; VOLTAGE RATING 50V; MPN CRCW04021R00FKEDC
R8: 0 Ohm; R_0402_1005Metric; TOLERANCE 5%; VOLTAGE RATING 50V; MPN CRCW04020000Z0ED
R9: 47k; R_0402_1005Metric; POWER RATING 50mW; TOLERANCE 5%; MPN CRCW040247K0JNEE
R11: 10k; R_0402_1005Metric; VOLTAGE RATING 50V; POWER RATING 63mW; MPN CRCW040210K0JNED
TP1, TP2, TP3, TP4, TP6, TP20: TP-SM-C-100; TestPoint_Pad_D1.0mm
U1: OPA836IDBVT; SOT-23-6_Handsoldering; PARTNUMBER OPA836IDBVT
U2: TPL0501-100RSER; Texas_UQFN-8_1.5x1.5mm_P0.5mm; PARTNUMBER TPL0501-100RSER
U3: AD8338ACPZ-R7; QFN50P300X300X80-17N; PARTREV B; DigiKey_Part_Number 505-AD8338ACPZ-R7CT-ND
U4, U5: TPS22916CYFPR; YFP0004ABAB; MPN TPS22916CYFPR; LCSC C2680319

Connections:
+V_PREAMP: C12.1, C15.2, U1.6 (VS+), U5.A1 (VOUT)
+V_RX: C9.2, C10.2, C11.1, C14.2, U2.7 (VDD), U4.A2 (VIN), U5.A2 (VIN); also elsewhere on the board
+V_VGA: C13.1, C16.2, U3.6 (MODE), U3.15 (VBAT), U4.A1 (VOUT)
/U_hv_mux_tr_sw/HV_MUX_SPI_MISO: U2.2 (DIN); also elsewhere on the board
/U_hv_mux_tr_sw/HV_MUX_SPI_SCLK: U2.5 (SCLK); also elsewhere on the board
/U_hv_mux_tr_sw/RX_OUT: C7.1, R5.1; also elsewhere on the board
/U_msp430/PREAMP_PWR_EN: TP4.1 (1_1), U5.B2 (ON); also elsewhere on the board
/U_msp430/VGA_GAIN_RC_EN: R4.1; also elsewhere on the board
/U_msp430/VGA_GAIN_RC_SINK: R1.1; also elsewhere on the board
/U_msp430/VGA_GAIN_SPI_CS: U2.3 (~CS); also elsewhere on the board
/U_msp430/VGA_PWR_EN: TP3.1, U4.B2 (ON); also elsewhere on the board
/U_rx_path/PREAMP_SHDN_N: R11.1, U1.5 (~PD); also elsewhere on the board
/U_rx_path/VGA_GAIN: C6.1, R1.2, TP1.1, U2.6 (W), U2.8 (L), U3.7 (GAIN)
/U_rx_path/VGA_IN: C1.2, C5.1, R3.2, TP2.1 (1_1), U1.1 (VOUT)
/U_rx_path/VGA_OUT: TP20.1 (1_1), U3.11 (OUTP); also elsewhere on the board
GND: C2.1, C3.1, C6.2, C8.2, C9.1, C10.1, C11.2, C12.2, C13.2, C14.1, C15.1, C16.1, C18.2, R7.1, R11.2, U1.2 (VS-), U2.4 (GND), U3.5 (COMM), U3.17 (EPAD), U4.B1 (GND), U5.B1 (GND); also elsewhere on the board
unnamed: C3.2, R2.1
unnamed: C7.2, R5.2, R6.1, R8.1
unnamed: R8.2, R9.2, U1.3 (VIN+)
unnamed: C1.1, R2.2, R3.1, R6.2, U1.4 (VIN-)
unnamed: R4.2, U2.1 (H)
unnamed: R7.2, U3.8 (DETO)
unnamed: C5.2, U3.4 (INMR)
unnamed: C4.2, U3.1 (INPR)
unnamed: C18.1, U3.14 (OFSN)
VGA_VREF: C2.2, C4.1, C8.1, R9.1, TP6.1 (1_1), U3.13 (VAGC), U3.16 (VREF)

Notes on the sheet:
VGA Gain Control
Power Down/ Mode Controls
Additional Decoupling Capacitors
Pre-Amplifier
Extra measurement points
VGA
Max. current is 2.5 mA
V-RX line
Abs. max. sink current is 2.5 mA (IO limit is 6 mA). Expected is 0.8 mA (when charged to 1.1V)
DC or AC coupled input
Preamplifier
Transimpedance Amplifier or Non-Inverted Amplifier

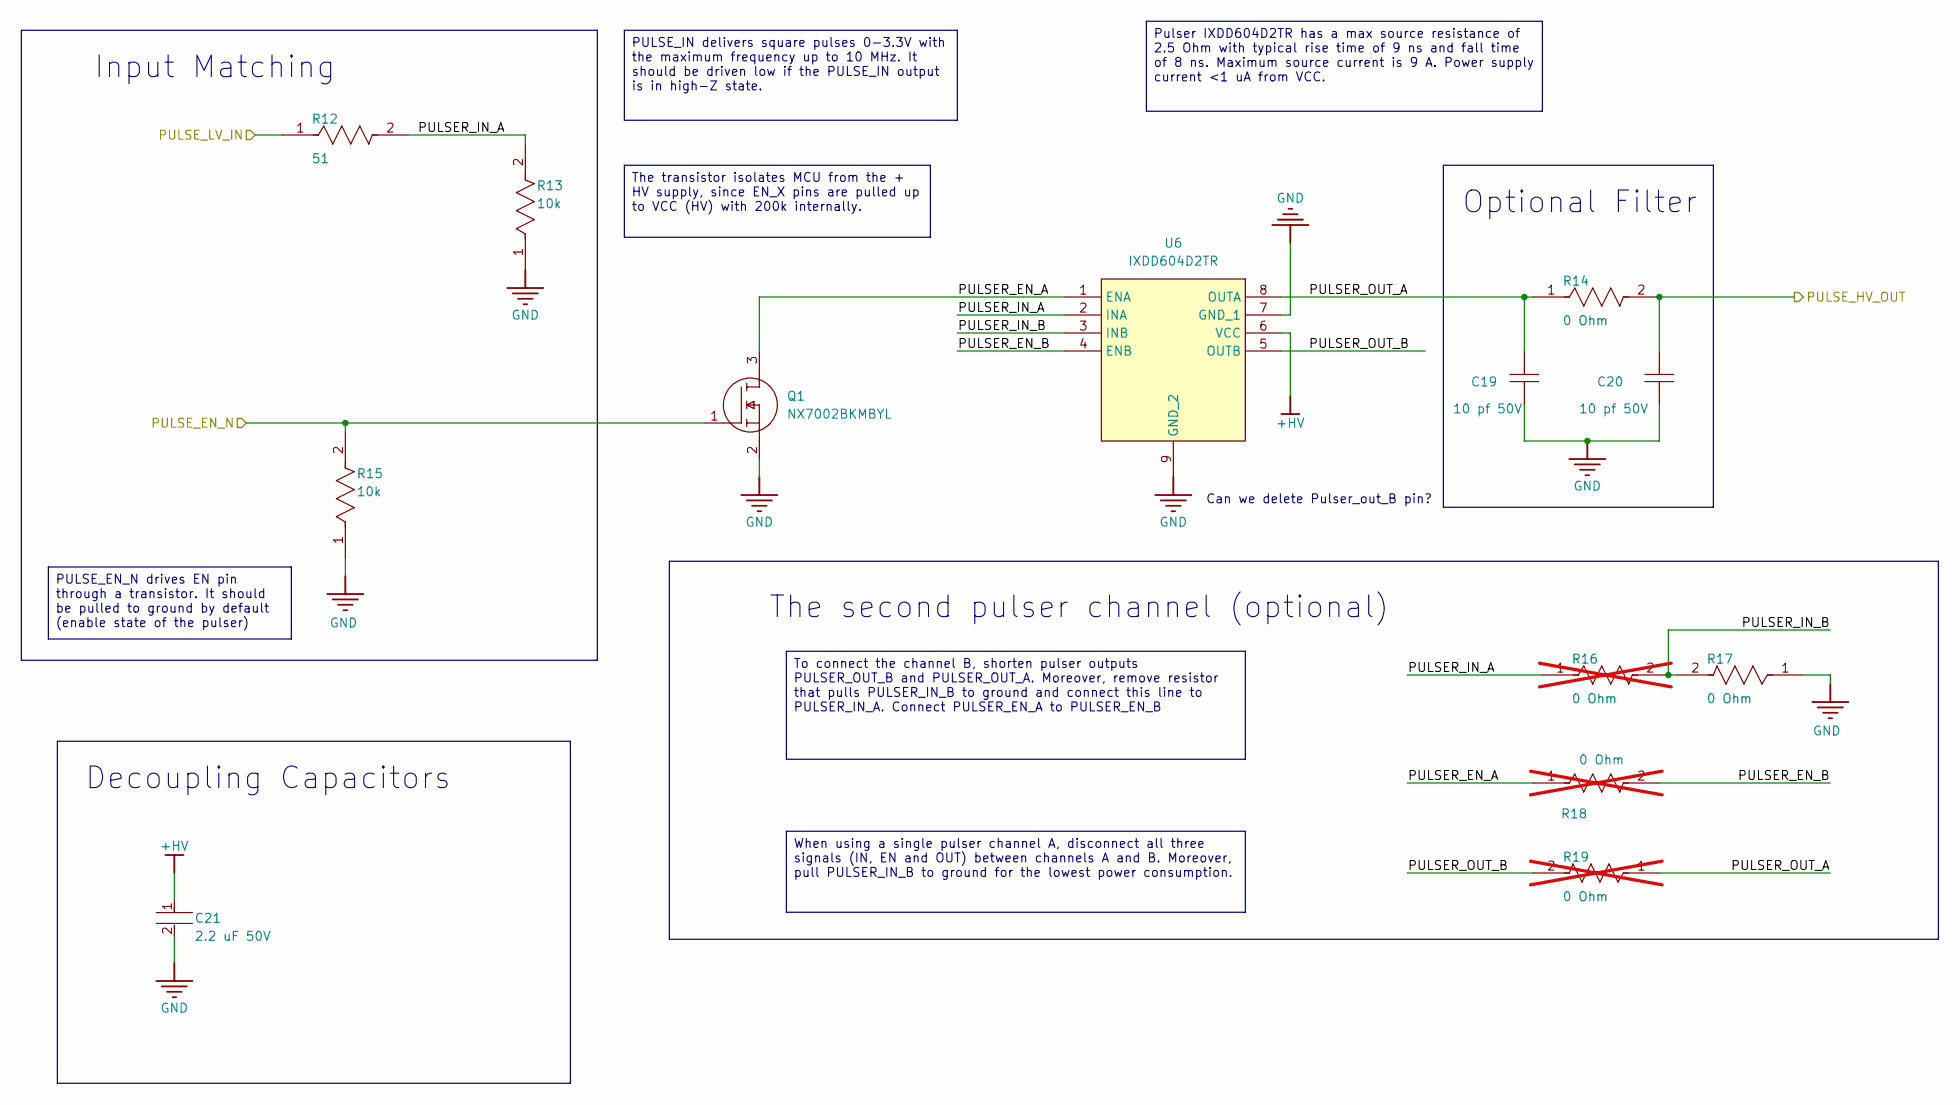
[picture p6: schematic tx_path.kicad_sch, WULPUS PRO]

Parts:
C19, C20: 10 pf 50V; C_0402_1005Metric; PART NUMBER GRM1555C1H100JA01D
C21: 2.2 uF 50V; C_0603_1608Metric; VOLTAGE RATING (DC) 50V; TOLERANCE 20%; PART NUMBER GRM188R61H225ME11D
Q1: NX7002BKMBYL; Diodes_DFN1006-3; MANUFACTURER_PART_NUMBER NX7002BKMBYL; MOUSER PART NUMBER 771-NX7002BKMBYL
R12: 51; R_0402_1005Metric; TOLERANCE 5%; POWER RATING 63mW; MPN CRCW040251R0JNED
R13, R15: 10k; R_0402_1005Metric; VOLTAGE RATING 50V; POWER RATING 63mW; MPN CRCW040210K0JNED
R14: 0 Ohm; R_0603_1608Metric; TOLERANCE 5%; VOLTAGE RATING 75V; MANUFACTURER PART NUMBER ERJ-3GEY0R00V; MOUSER DESCRIPTION Resistor, Chip Thick Film, 0 Ohm, 0.1w,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
R16, R18, R19: 0 Ohm; R_0402_1005Metric; TOLERANCE 5%; VOLTAGE RATING 50V; MPN CRCW04020000Z0ED; not fitted
R17: 0 Ohm; R_0402_1005Metric; TOLERANCE 5%; VOLTAGE RATING 50V; MPN CRCW04020000Z0ED
U6: IXDD604D2TR; IXYS_DFN-8_IXY; MANUFACTURER_PART_NUMBER IXDD604D2TR; MOUSER PART NUMBER 849-IXDD604D2TR

Connections:
+HV: C21.1, U6.6 (VCC); also elsewhere on the board
/U_hv_mux_tr_sw/TX_HV_PULSE_IN: C20.2, R14.2; also elsewhere on the board
/U_msp430/PULSER_HIZ_EN: Q1.1 (G), R15.2; also elsewhere on the board
/U_msp430/PULSER_OUT: R12.1; also elsewhere on the board
/U_tx_path/PULSER_EN_A: Q1.3 (D), R18.1, U6.1 (ENA)
/U_tx_path/PULSER_EN_B: R18.2, U6.4 (ENB)
/U_tx_path/PULSER_IN_A: R12.2, R13.2, R16.1, U6.2 (INA)
/U_tx_path/PULSER_IN_B: R16.2, R17.2, U6.3 (INB)
/U_tx_path/PULSER_OUT_A: C19.2, R14.1, R19.1, U6.8 (OUTA)
/U_tx_path/PULSER_OUT_B: R19.2, U6.5 (OUTB)
GND: C19.1, C20.1, C21.2, Q1.2 (S), R13.1, R15.1, R17.1, U6.7 (GND_1), U6.9 (GND_2); also elsewhere on the board

Notes on the sheet:
Can we delete Pulser_out_B pin?
The second pulser channel (optional)
Decoupling Capacitors
Input Matching
Optional Filter
PULSE_EN_N drives EN pin through a transistor. It should be pulled to ground by default (enable state of the pulser)
To connect the channel B, shorten pulser outputs PULSER_OUT_B and PULSER_OUT_A. Moreover, remove resistor that pulls PULSER_IN_B to ground and connect this line to PULSER_IN_A. Connect PULSER_EN_A to PULSER_EN_B
The transistor isolates MCU from the + HV supply, since EN_X pins are pulled up to VCC (HV) with 200k internally.
PULSE_IN delivers square pulses 0-3.3V with the maximum frequency up to 10 MHz. It should be driven low if the PULSE_IN output is in high-Z state.
Pulser IXDD604D2TR has a max source resistance of 2.5 Ohm with typical rise time of 9 ns and fall time of 8 ns. Maximum source current is 9 A. Power supply current <1 uA from VCC.
When using a single pulser channel A, disconnect all three signals (IN, EN and OUT) between channels A and B. Moreover, pull PULSER_IN_B to ground for the lowest power consumption.

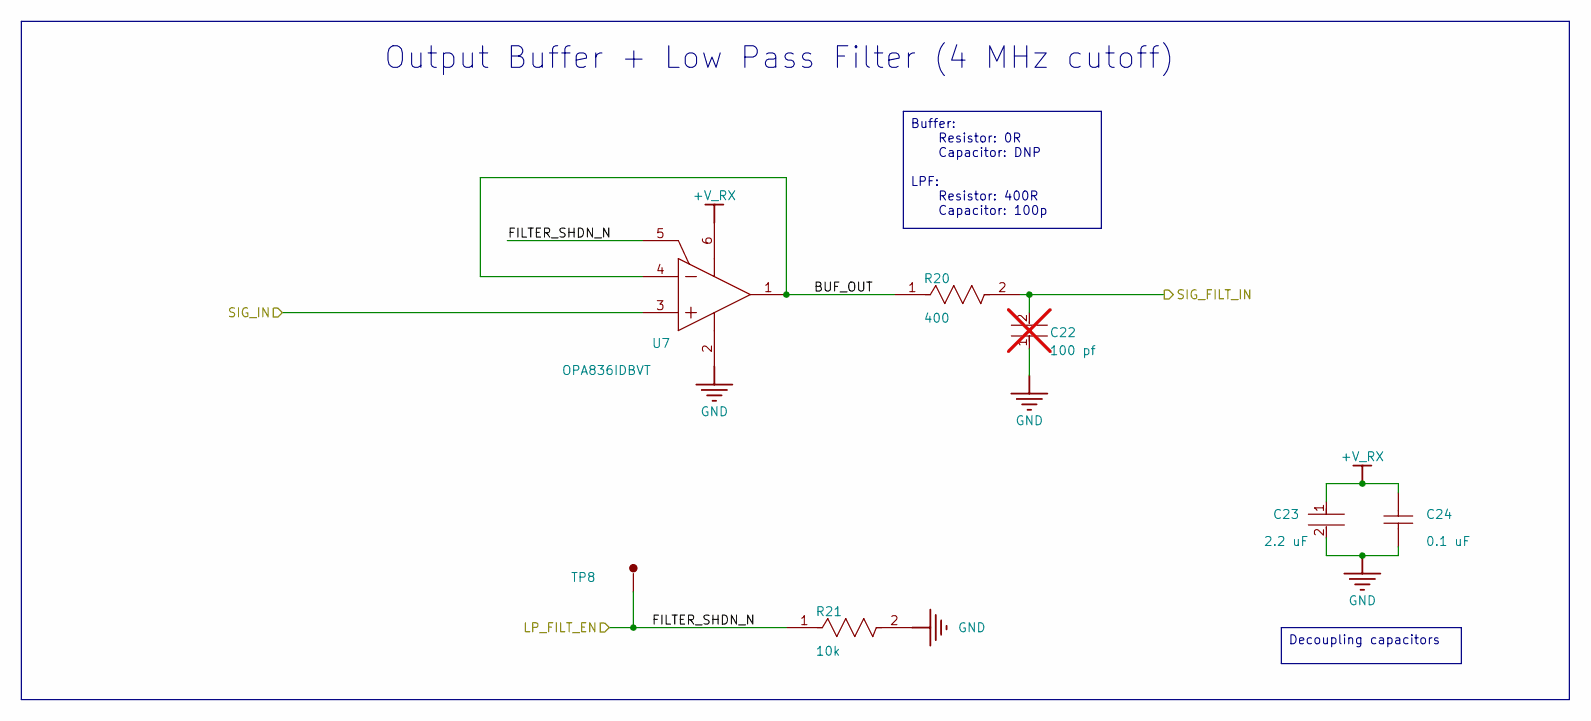
[picture p7: schematic rx_path_lp_filter.kicad_sch, WULPUS PRO]

Parts:
C22: 100 pf; C_0402_1005Metric; VOLTAGE 50V; TOLERANCE 1%; PART NUMBER 04025A101FAT2A; not fitted
C23: 2.2 uF; C_0402_1005Metric; VOLTAGE RATING 10V; VOLTAGE RATING (DC) 10V; PART NUMBER C1005X7S1A225K050BC
C24: 0.1 uF; C_0402_1005Metric; PART NUMBER C0402C104K4RACTU
R20: 400; R_0402_1005Metric; TOLERANCE 1%; VOLTAGE RATING 50V; MPN CRCW04021R00FKEDC
R21: 10k; R_0402_1005Metric; VOLTAGE RATING 50V; POWER RATING 63mW; MPN CRCW040210K0JNED
TP8: TP-SM-C-100; TestPoint_Pad_D1.0mm
U7: OPA836IDBVT; SOT-23-6_Handsoldering; PARTNUMBER OPA836IDBVT

Connections:
+V_RX: C23.1, C24.2, U7.6 (VS+); also elsewhere on the board
/U_msp430/ADC_IN: C22.2, R20.2; also elsewhere on the board
/U_rx_path/VGA_OUT: U7.3 (VIN+); also elsewhere on the board
/U_rx_path_lp_filter/BUF_OUT: R20.1, U7.1 (VOUT), U7.4 (VIN-)
/U_rx_path_lp_filter/FILTER_SHDN_N: R21.1, TP8.1, U7.5 (~PD); also elsewhere on the board
GND: C22.1, C23.2, C24.1, R21.2, U7.2 (VS-); also elsewhere on the board

Notes on the sheet:
Output Buffer + Low Pass Filter (4 MHz cutoff)
Decoupling capacitors
Buffer: Resistor: 0R Capacitor: DNP LPF: Resistor: 400R Capacitor: 100p

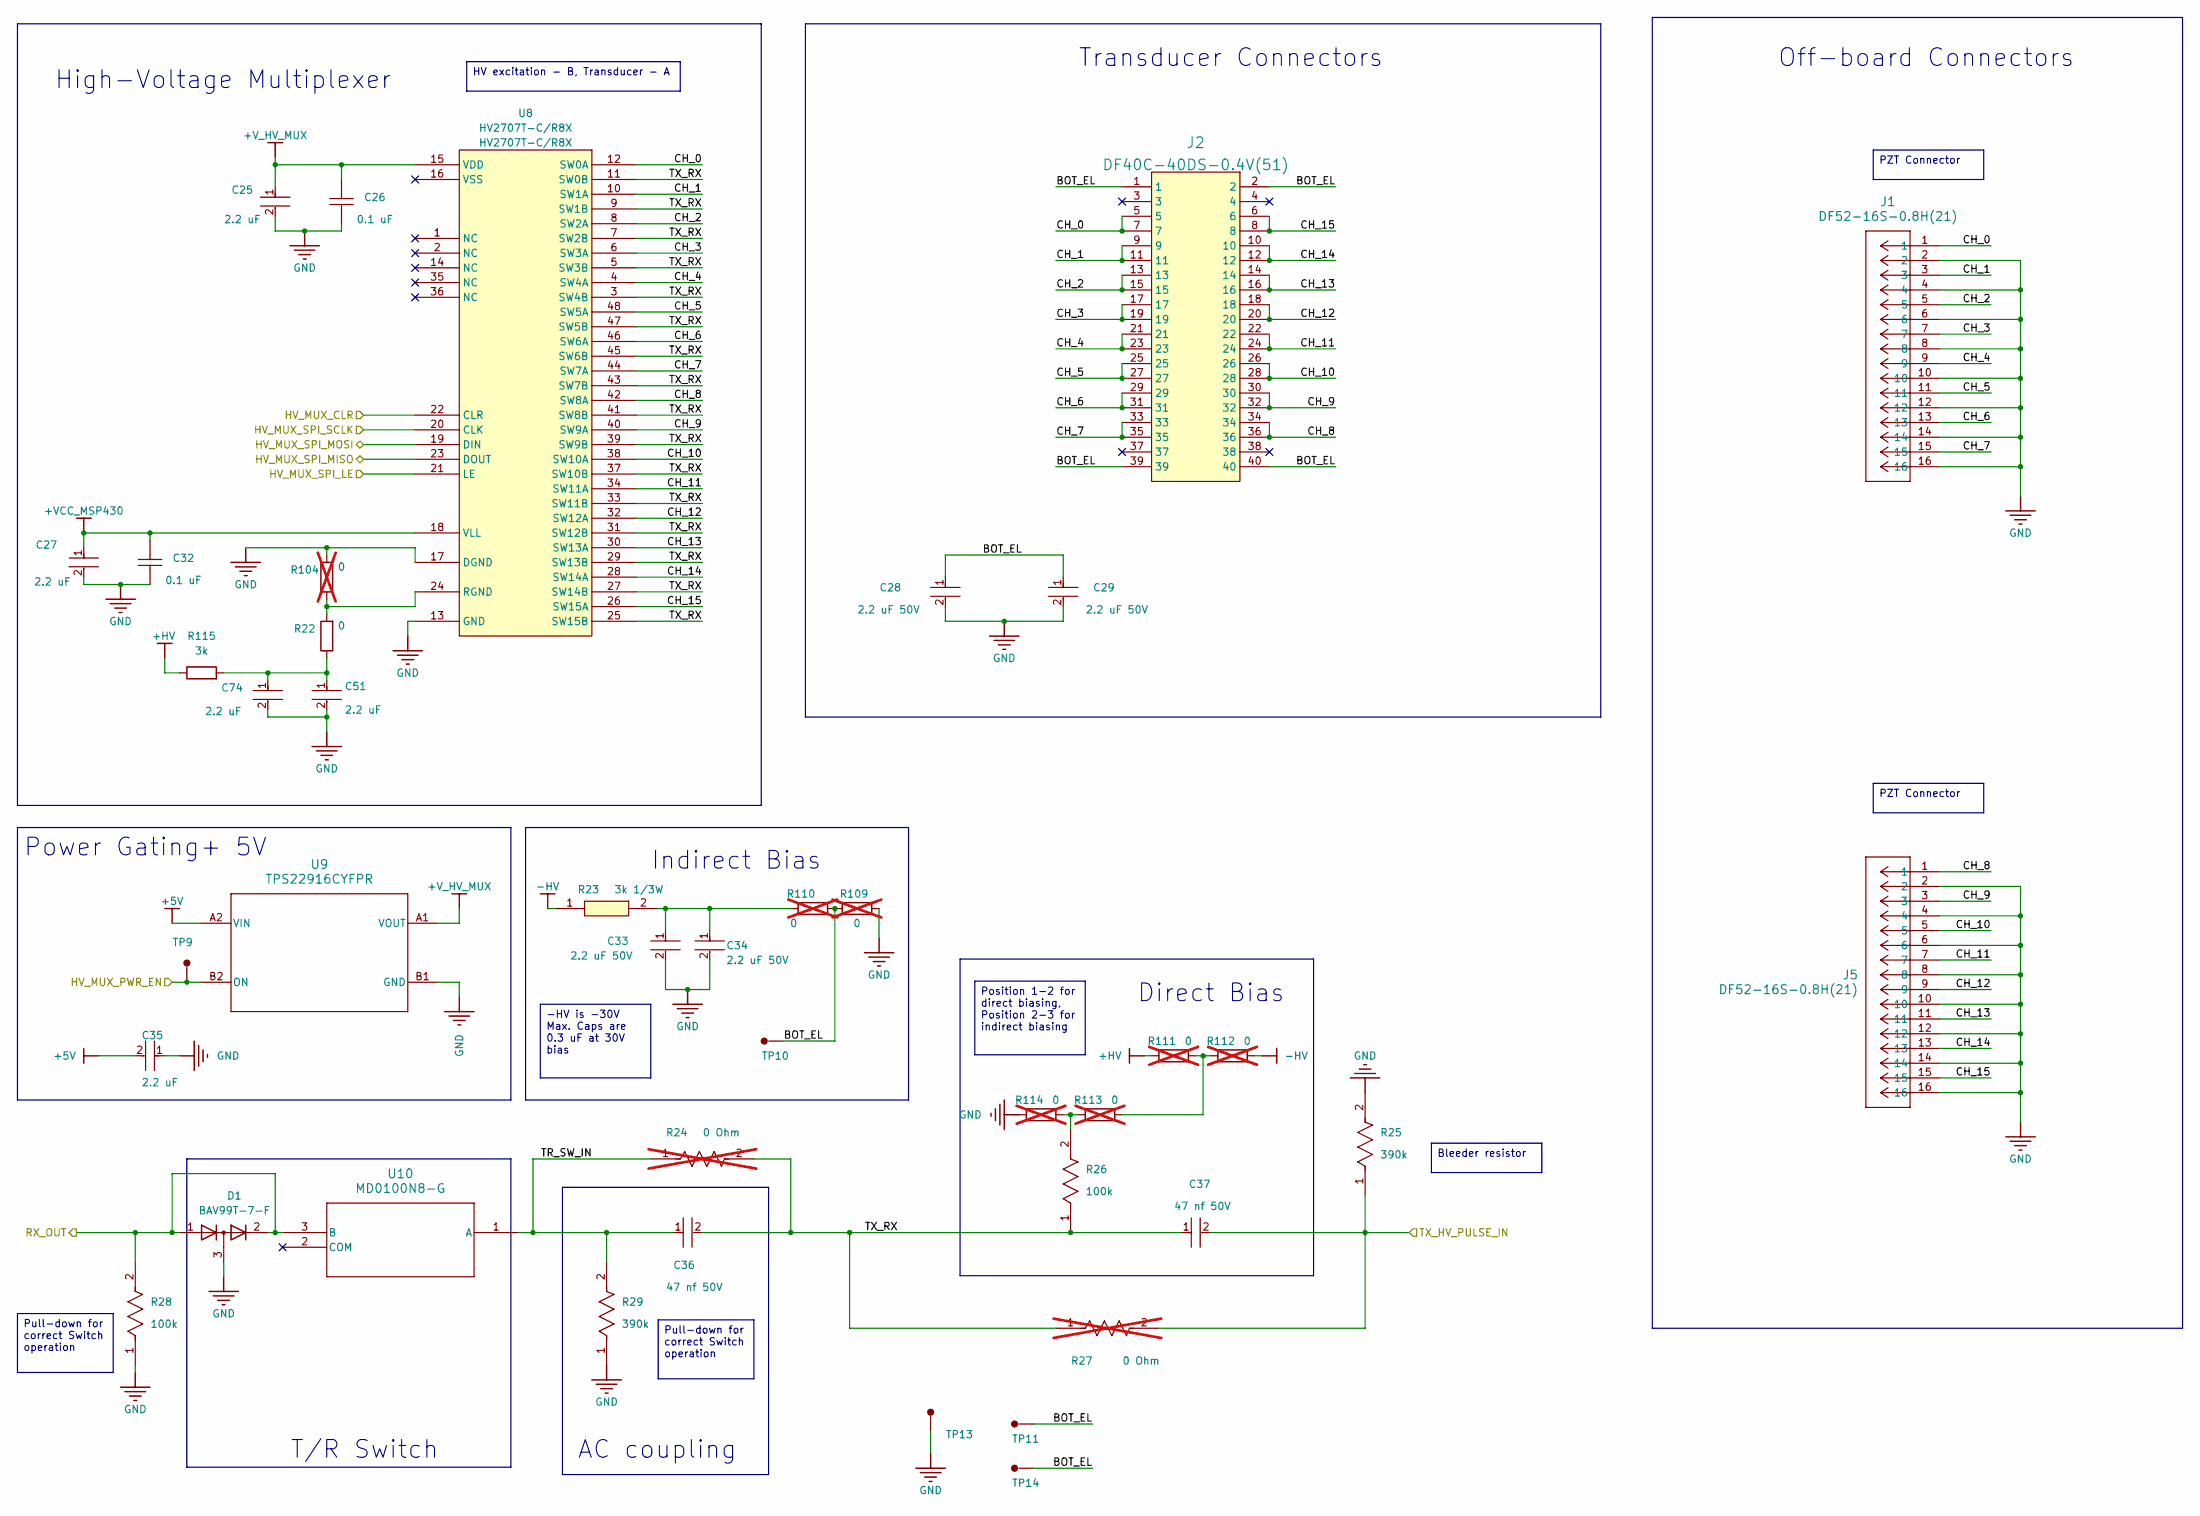
[picture p8: schematic hv_mux_tr_sw.kicad_sch, WULPUS PRO]

Parts:
C25, C27, C35, C51, C74: 2.2 uF; C_0402_1005Metric; VOLTAGE RATING 10V; VOLTAGE RATING (DC) 10V; PART NUMBER C1005X7S1A225K050BC
C26, C32: 0.1 uF; C_0402_1005Metric; PART NUMBER C0402C104K4RACTU
C28, C29, C33, C34: 2.2 uF 50V; C_0603_1608Metric; VOLTAGE RATING (DC) 50V; TOLERANCE 20%; PART NUMBER GRM188R61H225ME11
C36, C37: 47 nf 50V; C_0402_1005Metric; TOLERANCE 20%; VOLTAGE RATING (DC) 50V; PART NUMBER GRM155R71H473ME14D
D1: BAV99T-7-F; SOT-523; MPN BAV99T-7-F
J1, J5: DF52-16S-0.8H(21); CONN_DF52-16S-0.8H21_HIR; MPN DF52-16S-0.8H(21); LCSC C22281399
J2: DF40C-40DS-0.4V(51); Hirose_DF40C-40DS-0.4V_2x20_P0.4mm; MPN DF40C-40DS-0.4V(51)
R22: 0; R_0402_1005Metric; Tolerance 5%; MPN ERJ-2GE0R00X; LCSC C17168
R23: 3k 1/3W; R_0603_1608Metric; MANUFACTURER_PART_NUMBER ERJ-PA3J302V; MOUSER PART NUMBER 667-ERJ-PA3J302V
R24, R27: 0 Ohm; R_0402_1005Metric; TOLERANCE 5%; VOLTAGE RATING 50V; MPN CRCW04020000Z0ED; not fitted
R25, R29: 390k; R_0402_1005Metric; VOLTAGE RATING (DC) 50V; TOLERANCE 1%; MPN RC1005F394CS
R26, R28: 100k; R_0402_1005Metric; VOLTAGE RATING (DC) 50V; TOLERANCE 1%; MPN ERJ-2RKF1003X
R104, R109, R110, R111, R112, R113, R114: 0; R_0402_1005Metric; Tolerance 5%; MPN ERJ-2GE0R00X; LCSC C17168; not fitted
R115: 3k; R_0402_1005Metric; MPN CRCW06033K00FKEAHP
TP9, TP10, TP11, TP13, TP14: TP-SM-C-100; TestPoint_Pad_D1.0mm
U8: HV2707T-C/R8X; LQFP-48_7x7mm_P0.5mm; MANUFACTURER PART NUMBER HV2707T-C/R8X; LCSC C3656525
U9: TPS22916CYFPR; YFP0004ABAB; MPN TPS22916CYFPR; LCSC C2680319
U10: MD0100N8-G; TO-243AA_MCH; MPN MD0100N8-G; LCSC C629131

Connections:
+5V: C35.2, U9.A2 (VIN); also elsewhere on the board
+HV: R111.1, R115.1; also elsewhere on the board
+VBAT_STM: C27.1, C32.2, U8.18 (VLL); also elsewhere on the board
+V_HV_MUX: C25.1, C26.2, U8.15 (VDD), U9.A1 (VOUT)
-HV: R23.1, R112.2; also elsewhere on the board
/U_hv_mux_tr_sw/BOT_EL: C28.1, C29.1, J2.1, J2.2, J2.39, J2.40, R109.1, R110.2, TP10.1 (1_1), TP11.1 (1_1), TP14.1 (1_1)
/U_hv_mux_tr_sw/CH_0: J1.1, J2.5, J2.7, U8.12 (SW0A)
/U_hv_mux_tr_sw/CH_1: J1.3, J2.9, J2.11, U8.10 (SW1A)
/U_hv_mux_tr_sw/CH_2: J1.5, J2.13, J2.15, U8.8 (SW2A)
/U_hv_mux_tr_sw/CH_3: J1.7, J2.17, J2.19, U8.6 (SW3A)
/U_hv_mux_tr_sw/CH_4: J1.9, J2.21, J2.23, U8.4 (SW4A)
/U_hv_mux_tr_sw/CH_5: J1.11, J2.25, J2.27, U8.48 (SW5A)
/U_hv_mux_tr_sw/CH_6: J1.13, J2.29, J2.31, U8.46 (SW6A)
/U_hv_mux_tr_sw/CH_7: J1.15, J2.33, J2.35, U8.44 (SW7A)
/U_hv_mux_tr_sw/CH_8: J2.34, J2.36, J5.1, U8.42 (SW8A)
/U_hv_mux_tr_sw/CH_9: J2.30, J2.32, J5.3, U8.40 (SW9A)
/U_hv_mux_tr_sw/CH_10: J2.26, J2.28, J5.5, U8.38 (SW10A)
/U_hv_mux_tr_sw/CH_11: J2.22, J2.24, J5.7, U8.34 (SW11A)
/U_hv_mux_tr_sw/CH_12: J2.18, J2.20, J5.9, U8.32 (SW12A)
/U_hv_mux_tr_sw/CH_13: J2.14, J2.16, J5.11, U8.30 (SW13A)
/U_hv_mux_tr_sw/CH_14: J2.10, J2.12, J5.13, U8.28 (SW14A)
/U_hv_mux_tr_sw/CH_15: J2.6, J2.8, J5.15, U8.26 (SW15A)
/U_hv_mux_tr_sw/HV_MUX_CLR: U8.22 (CLR); also elsewhere on the board
/U_hv_mux_tr_sw/HV_MUX_PWR_EN: TP9.1 (1_1), U9.B2 (ON); also elsewhere on the board
/U_hv_mux_tr_sw/HV_MUX_SPI_LE: U8.21 (LE); also elsewhere on the board
/U_hv_mux_tr_sw/HV_MUX_SPI_MISO: U8.23 (DOUT); also elsewhere on the board
/U_hv_mux_tr_sw/HV_MUX_SPI_MOSI: U8.19 (DIN); also elsewhere on the board
/U_hv_mux_tr_sw/HV_MUX_SPI_SCLK: U8.20 (CLK); also elsewhere on the board
/U_hv_mux_tr_sw/RX_OUT: D1.1 (A), D1.2 (K), R28.2, U10.3 (B); also elsewhere on the board
/U_hv_mux_tr_sw/TR_SW_IN: C36.1, R24.1, R29.2, U10.1 (A)
/U_hv_mux_tr_sw/TX_HV_PULSE_IN: C37.2, R25.1, R27.2; also elsewhere on the board
/U_hv_mux_tr_sw/TX_RX: C36.2, C37.1, R24.2, R26.1, R27.1, U8.3 (SW4B), U8.5 (SW3B), U8.7 (SW2B), U8.9 (SW1B), U8.11 (SW0B), U8.25 (SW15B), U8.27 (SW14B), U8.29 (SW13B), U8.31 (SW12B), U8.33 (SW11B), U8.37 (SW10B), U8.39 (SW9B), U8.41 (SW8B), U8.43 (SW7B), U8.45 (SW6B), U8.47 (SW5B)
GND: C25.2, C26.1, C27.2, C28.2, C29.2, C32.1, C33.2, C34.2, C35.1, C51.2, C74.2, D1.3 (common), J1.2, J1.4, J1.6, J1.8, J1.10, J1.12, J1.14, J1.16, J5.2, J5.4, J5.6, J5.8, J5.10, J5.12, J5.14, J5.16, R25.2, R28.1, R29.1, R104.2, R109.2, R114.1, TP13.1 (1_1), U8.13 (GND), U8.17 (DGND), U9.B1 (GND); also elsewhere on the board
unnamed: C33.1, C34.1, R23.2, R110.1
unnamed: C51.1, C74.1, R22.1, R115.2
unnamed: R111.2, R112.1, R113.2
unnamed: R26.2, R113.1, R114.2
unnamed: R22.2, R104.1, U8.24 (RGND)

Notes on the sheet:
Direct Bias
High-Voltage Multiplexer
Power Gating+ 5V
AC coupling
Transducer Connectors
T/R Switch
Off-board Connectors
Indirect Bias
Bleeder resistor
-HV is -30V Max. Caps are 0.3 uF at 30V bias
Position 1-2 for direct biasing, Position 2-3 for indirect biasing
HV excitation - B, Transducer - A
PZT Connector
Pull-down for correct Switch operation

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
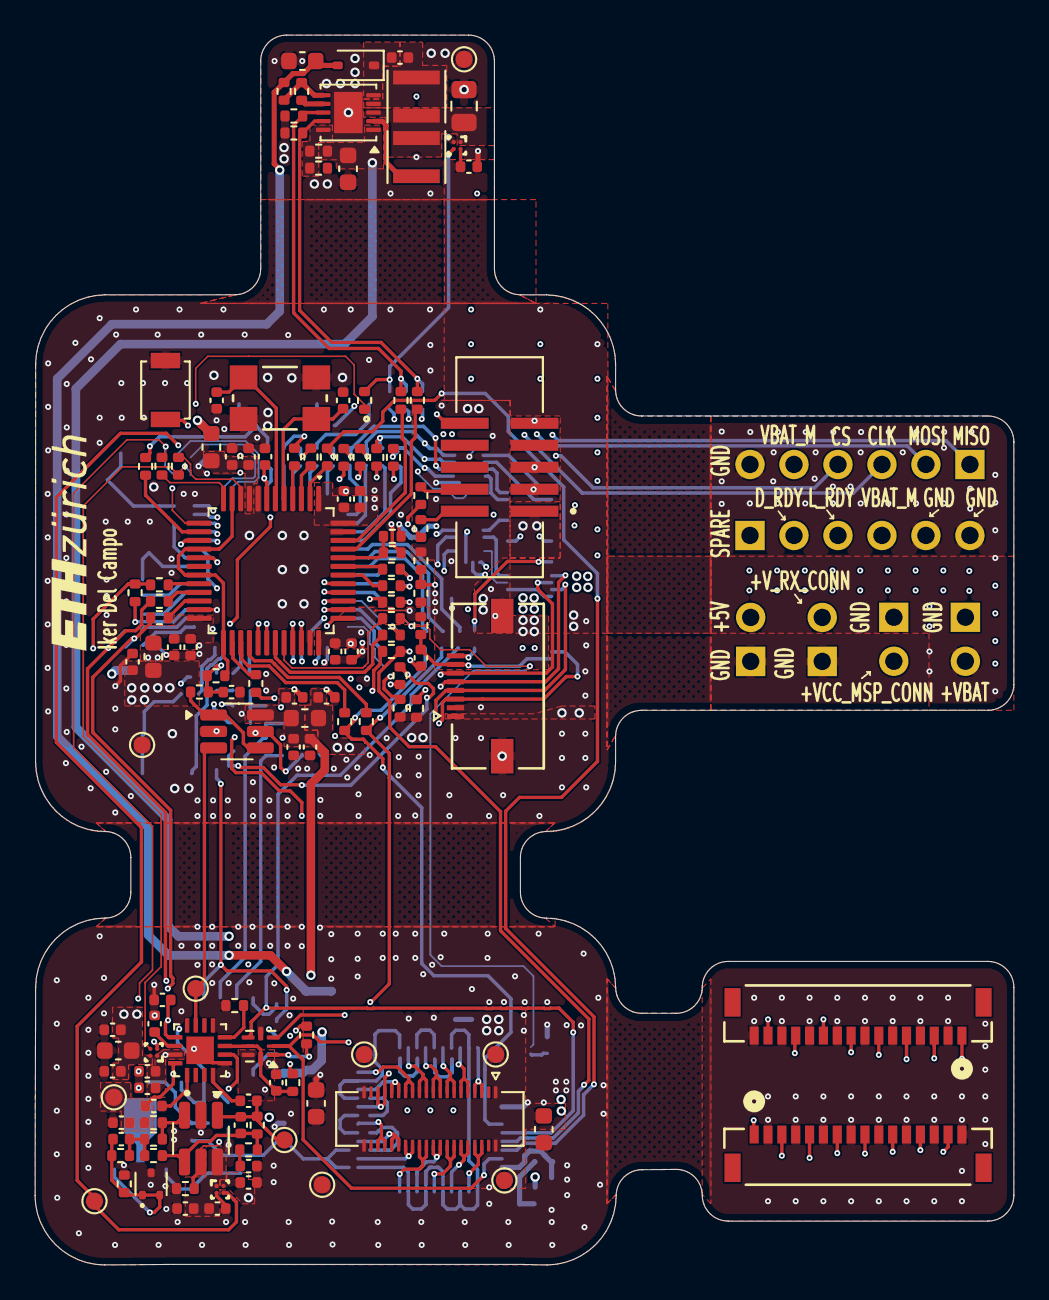
[picture p9: board wulpus_pro_acq_pcb.kicad_pcb from above]

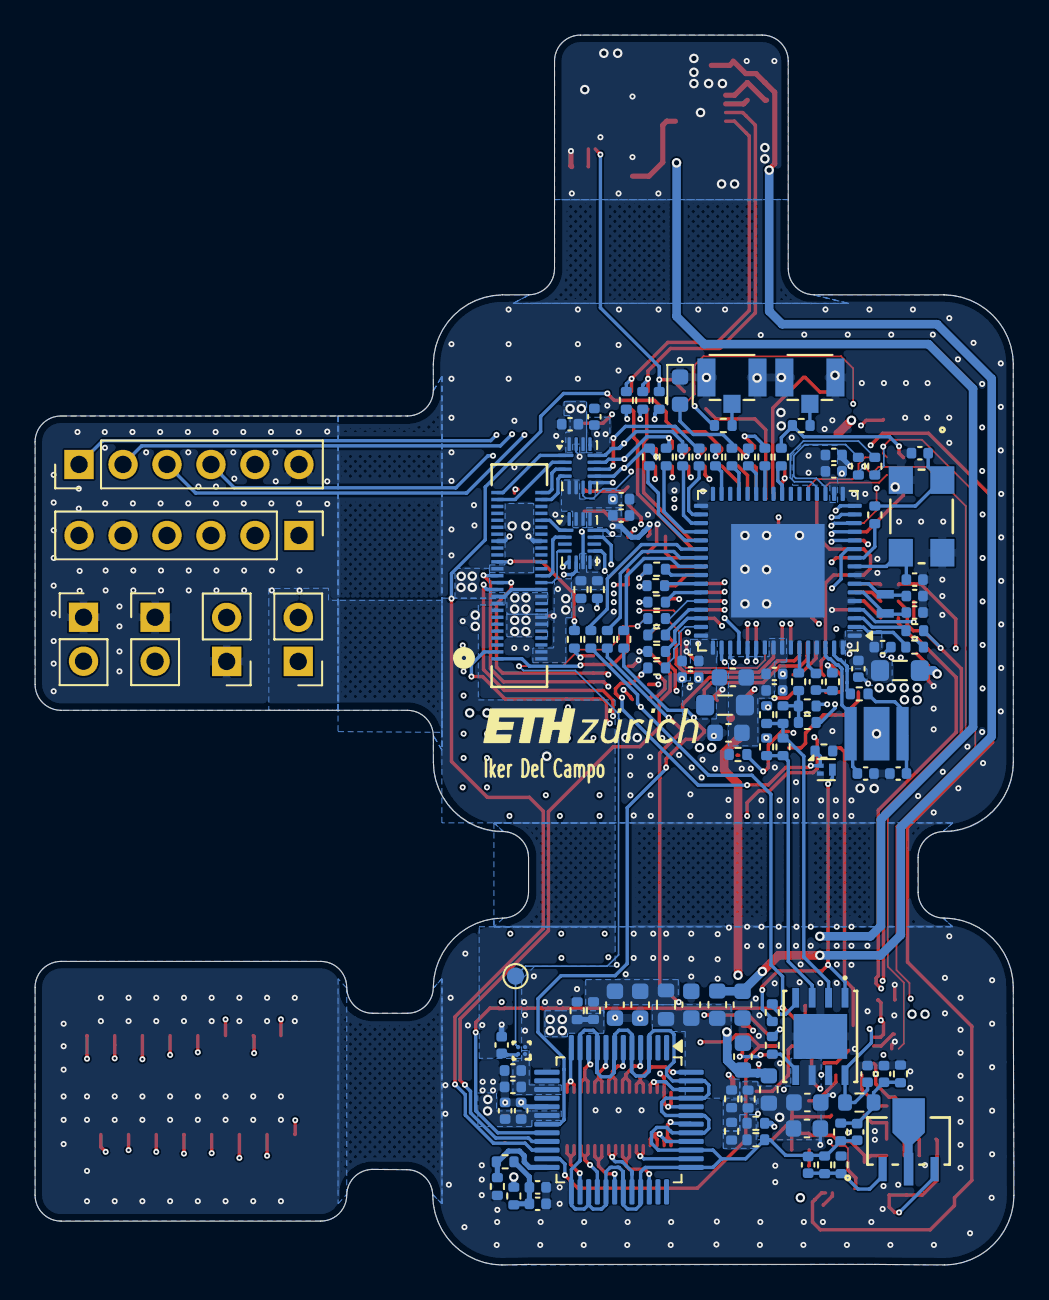
[picture p10: board wulpus_pro_acq_pcb.kicad_pcb from below]

Board: 4 copper layers, 56.5 x 71.0 mm, 258 parts (127 on the bottom side), 195 nets.

Other parts of the board:
ART1#2: ETH Zurich Logo silkscreen; ETH_zurich_2mm
C17: 2.2uF; C_0402_1005Metric
C56, C57, C58, C60, C61, C62: 2.2 uF 50V; C_0603_1608Metric
C59: 1 uF 50V; C_0805_2012Metric
C63: 0.1 uF 50V; C_0402_1005Metric
C64, C65, C66, C67: 1 uF 10V; C_0402_1005Metric
D3: ZHCS400QTA; D_SOD-323
FB1, FB2, FB3, FB4: 100Ω@100MHz; L_0603_1608Metric
L3, L4: 10uH; IND_LQH3NPZ100MMEL
R38, R43: 1MΩ; R_0402_1005Metric
R39: 43.2 kΩ; R_0402_1005Metric
R40: 41.2 kΩ; R_0402_1005Metric
R41, R42: 10k; R_0402_1005Metric
U12: LT3463EDD#PBF; DFN-10-1EP_3x3mm_P0.5mm_EP1.65x2.38mm
U13: TPS22916CYFPR; YFP0004ABAB

Their connections:
+HV: C61.1, FB2.2; also elsewhere on the board
+VBAT: C17.2, U13.A2 (VIN); also elsewhere on the board
+VBAT_STM: C65.1, FB3.2; also elsewhere on the board
+VCC_MSP430_CONN: C64.1, FB3.1; also elsewhere on the board
+V_IN_HV: C59.1, L3.1, L4.1, U12.3 (VIN), U13.A1 (VOUT)
+V_RX: C67.1, FB4.2; also elsewhere on the board
+V_RX_CONN: C66.1, FB4.1; also elsewhere on the board
-HV: C57.1, FB1.2; also elsewhere on the board
/U_msp430/HV_PWR_EN: U13.B2 (ON); also elsewhere on the board
/U_power/HV_EN1: R41.1, U12.9 (~SHDN1); also elsewhere on the board
/U_power/HV_EN2: R42.1, U12.8 (~SHDN2); also elsewhere on the board
GND: C17.1, C56.2, C57.2, C58.2, C59.2, C60.2, C61.2, C62.2, C64.2, C65.2, C66.2, C67.2, R39.2, R41.2, R42.2, U12.11 (EP), U13.B1 (GND); also elsewhere on the board
unnamed: C63.1, D3.1 (K), U12.5 (D2)
unnamed: R38.1, R39.1, U12.10 (FB1)
unnamed: R40.2, R43.2, U12.6 (FB2)
unnamed: L3.2, U12.2 (SW1)
unnamed: C63.2, L4.2, U12.4 (SW2)
unnamed: R40.1, U12.7 (VREF)
VOUT_NEG: C56.1, C62.1, D3.2 (A), FB1.1, R43.1
VOUT_POS: C58.1, C60.1, FB2.1, R38.2, U12.1 (VOUT1)
