ikerdcm/wulpus-pro_fpc/fw/stm32f303cc/Core/Src/main.c

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
/* Includes ------------------------------------------------------------------*/
#include "main.h"

ADC_HandleTypeDef hadc1;
ADC_HandleTypeDef hadc2;
ADC_HandleTypeDef hadc3;
ADC_HandleTypeDef hadc4;
DMA_HandleTypeDef hdma_adc1;
DMA_HandleTypeDef hdma_adc2;
DMA_HandleTypeDef hdma_adc3;
DMA_HandleTypeDef hdma_adc4;

SPI_HandleTypeDef hspi1;
SPI_HandleTypeDef hspi2;
SPI_HandleTypeDef hspi3;

TIM_HandleTypeDef htim1;

/* USER CODE BEGIN PV */

#define BUFFER_SIZE 1000
#define TOTAL_SAMPLES (BUFFER_SIZE * 4)

uint16_t adc1_buf[BUFFER_SIZE];
uint16_t adc2_buf[BUFFER_SIZE];
uint16_t adc3_buf[BUFFER_SIZE];
uint16_t adc4_buf[BUFFER_SIZE];

uint16_t interleaved_buffer[TOTAL_SAMPLES];

volatile uint8_t dma_half_ready = 0;
volatile uint8_t dma_full_ready = 0;

// Diferencias medidas respecto al ADC1
int16_t offset_adc2 = 0;  
int16_t offset_adc4 = 0; 
int16_t offset_adc3 = 0; 

//int16_t offset_adc2 = -57;  // 1117 - 1174
//int16_t offset_adc4 = -73;  // 1117 - 1190
//int16_t offset_adc3 = -69;  // 1117 - 1186

/* USER CODE END PV */

void SystemClock_Config(void);
static void MX_GPIO_Init(void);
static void MX_DMA_Init(void);
static void MX_ADC1_Init(void);
static void MX_ADC2_Init(void);
static void MX_ADC3_Init(void);
static void MX_ADC4_Init(void);
static void MX_SPI2_Init(void);
static void MX_SPI3_Init(void);
static void MX_SPI1_Init(void);
static void MX_TIM1_Init(void);
/**
  * @brief  The application entry point.
  * @retval int
  */
int main(void)
{

  /* MCU Configuration--------------------------------------------------------*/

  /* Reset of all peripherals, Initializes the Flash interface and the Systick. */
  HAL_Init();

  /* Configure the system clock */
  SystemClock_Config();

  /* Initialize all configured peripherals */
  MX_GPIO_Init();
  MX_DMA_Init();
  MX_ADC1_Init();
  MX_ADC2_Init();
  MX_ADC3_Init();
  MX_ADC4_Init();
  MX_SPI2_Init();
  MX_SPI3_Init();
  MX_SPI1_Init();
  MX_TIM1_Init();
  /* USER CODE BEGIN 2 */
  
  /* 0. Calibrate ADCs */
  HAL_ADCEx_Calibration_Start(&hadc1, ADC_SINGLE_ENDED);
  HAL_ADCEx_Calibration_Start(&hadc2, ADC_SINGLE_ENDED);
  HAL_ADCEx_Calibration_Start(&hadc3, ADC_SINGLE_ENDED);
  HAL_ADCEx_Calibration_Start(&hadc4, ADC_SINGLE_ENDED);

  /* 1. Enable PWM pins silently (DO NOT start the Timer clock yet!) */
  TIM_CCxChannelCmd(htim1.Instance, TIM_CHANNEL_2, TIM_CCx_ENABLE);
  TIM_CCxChannelCmd(htim1.Instance, TIM_CHANNEL_3, TIM_CCx_ENABLE);
  TIM_CCxChannelCmd(htim1.Instance, TIM_CHANNEL_4, TIM_CCx_ENABLE);
  __HAL_TIM_MOE_ENABLE(&htim1);

  /* 2. Clear flags to avoid ghost triggers */
  htim1.Instance->EGR = TIM_EGR_UG;
  __HAL_TIM_CLEAR_FLAG(&htim1, TIM_FLAG_UPDATE);

  /* 3. Arm ADCs. They will wait synchronously for the first clock tick */
  HAL_ADC_Start_DMA(&hadc1, (uint32_t*)adc1_buf, BUFFER_SIZE);
  HAL_ADC_Start_DMA(&hadc2, (uint32_t*)adc2_buf, BUFFER_SIZE);
  HAL_ADC_Start_DMA(&hadc3, (uint32_t*)adc3_buf, BUFFER_SIZE);
  HAL_ADC_Start_DMA(&hadc4, (uint32_t*)adc4_buf, BUFFER_SIZE);

  /* 4. FIRE! Start the master clock */
  __HAL_TIM_ENABLE(&htim1);

  /* USER CODE END 2 */

  /* Infinite loop */
  /* USER CODE BEGIN WHILE */
  
  while (1)
  {
    if (dma_half_ready)
    {
        dma_half_ready = 0;
        Interleave_Data(0, BUFFER_SIZE / 2);
    }
    
    if (dma_full_ready)
    {
        dma_full_ready = 0;
        Interleave_Data(BUFFER_SIZE / 2, BUFFER_SIZE);

        __NOP();
        
        /* Your interleaved_buffer is completely updated here. */
        /* You can pass it to your Edge AI processing pipeline. */
    }
    /* USER CODE END WHILE */

    /* USER CODE BEGIN 3 */
  }
  /* USER CODE END 3 */
}

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
