ikerdcm/wulpus-pro_fpc/fw/stm32f303cc/stm32f303.ioc

Mcu.UserName=STM32F303CCTx
PA0.GPIO_Label=VGA_PWR_EN
PA0.Signal=GPIO_Output
PA1.Signal=ADC1_IN2
PA10.GPIO_Label=TRIG_OUT
PA10.Signal=GPIO_Output
PA11.GPIO_Label=HV_MUX_PWR_EN
PA11.Signal=GPIO_Output
PA12.GPIO_Label=HOST_SPARE_PIN
PA12.Signal=GPIO_Output
PA13.Signal=SYS_JTMS-SWDIO
PA14.Signal=SYS_JTCK-SWCLK
PA15.GPIO_Label=HOST_SPI_CS
PA15.Signal=GPIO_Input
PA2.GPIO_Label=PREAMP_EN
PA2.Signal=GPIO_Output
PA3.GPIO_Label=HV_PWR_EN
PA3.Signal=GPIO_Output
PA4.GPIO_Label=UUPS_TRIG_IN
PA4.Signal=GPIO_Input
PA5.GPIO_Label=PULS_SPI_SCK
PA5.Signal=SPI1_SCK
PA6.Signal=ADC2_IN3
PA7.GPIO_Label=PULS_SPI_MOSI
PA7.Signal=SPI1_MOSI
PA8.GPIO_Label=PULS_HIZ_EN
PA8.Signal=GPIO_Output
PA9.GPIO_Label=HV_MUX_SPI_CS
PA9.Signal=GPIO_Output
PB1.Signal=ADC3_IN1
PB10.GPIO_Label=VGA_GAIN_RC_EN
PB10.Signal=GPIO_Output
PB11.GPIO_Label=VGA_GAIN_RC_SINK
PB11.Signal=GPIO_Input
PB12.Signal=ADC4_IN3
PB13.GPIO_Label=CTRL_SPI_SCK
PB13.Signal=SPI2_SCK
PB14.GPIO_Label=CTRL_SPI_MISO
PB14.Signal=SPI2_MISO
PB15.GPIO_Label=CTRL_SPI_MOSI
PB15.Signal=SPI2_MOSI
PB2.GPIO_Label=VGA_GAIN_SPI_CS
PB2.Signal=GPIO_Output
PB3.GPIO_Label=HOST_SPI_SCK
PB3.Signal=SPI3_SCK
PB4.GPIO_Label=HOST_SPI_MISO
PB4.Signal=SPI3_MISO
PB5.GPIO_Label=HOST_SPI_MOSI
PB5.Signal=SPI3_MOSI
PB6.GPIO_Label=HOST_DATA_READY
PB6.Signal=GPIO_Output
PB7.GPIO_Label=HOST_LINK_READY
PB7.Signal=GPIO_Input
PB8.GPIO_Label=HV_POS_EN
PB8.Signal=GPIO_Output
PB9.GPIO_Label=HV_NEG_EN
PB9.Signal=GPIO_Output
PC13.GPIO_Label=HV_MUX_CLR
PC13.Signal=GPIO_Output
PC14-OSC32_IN.GPIO_Label=LP_FILT_EN
PC14-OSC32_IN.Signal=GPIO_Output
PC15-OSC32_OUT.GPIO_Label=PREAMP_PWR_EN
PC15-OSC32_OUT.Signal=GPIO_Output
PF0-OSC_IN.Signal=RCC_OSC_IN
PF1-OSC_OUT.Signal=RCC_OSC_OUT
