ikerdcm/wulpus-pro_fpc/(commit log)

2026-03-08 Migration to KiCad initiated
    [host_connector.kicad_sch, hv_mux_tr_sw.kicad_sch, main.kicad_sch, msp430.kicad_sch, power.kicad_sch, rx_path.kicad_sch, rx_path_lp_filter.kicad_sch, tx_path.kicad_sch]
2026-03-12 Migration of WULPUS Pro completed
    [U_stm32F303.kicad_sch, host_connector.kicad_sch, hv_mux_tr_sw.kicad_sch, msp430.kicad_sch, power.kicad_sch, rx_path.kicad_sch, rx_path_lp_filter.kicad_sch, tx_path.kicad_sch]
2026-03-19 Schematics finished, waiting for approval. PCB Placement started
    [host_connector.kicad_sch, hv_mux_tr_sw.kicad_sch, msp430.kicad_sch, power.kicad_sch, rx_path.kicad_sch, tx_path.kicad_sch, wulpus_pro_acq_pcb.kicad_pcb, wulpus_pro_acq_pcb.kicad_sch]
2026-03-23 Placement of all modules except PWR and PWR MUX completed
    [host_connector.kicad_sch, hv_mux_tr_sw.kicad_sch, msp430.kicad_sch, rx_path.kicad_sch, rx_path_lp_filter.kicad_sch, wulpus_pro_acq_pcb.kicad_pcb]
2026-03-25 One transducer connector removed (only one remains); SWD connector for STM changed; Advances in the placement
    [host_connector.kicad_sch, hv_mux_tr_sw.kicad_sch, msp430.kicad_sch, power.kicad_sch, rx_path.kicad_sch, rx_path_lp_filter.kicad_sch, tx_path.kicad_sch, wulpus_pro_acq_pcb.kicad_pcb]
2026-03-28 KiCad 10 migration; Board outline difined; Routing continued
    [host_connector.kicad_sch, hv_mux_tr_sw.kicad_sch, msp430.kicad_sch, power.kicad_sch, rx_path.kicad_sch, rx_path_lp_filter.kicad_sch, tx_path.kicad_sch, wulpus_pro_acq_pcb.kicad_pcb]
2026-04-01 Routing of all PCB except VBAT completed; DRC yet to pass
    [hv_mux_tr_sw.kicad_sch, msp430.kicad_sch, power.kicad_sch, wulpus_pro_acq_pcb.kicad_pcb]
2026-04-06 Routing finished, Via stitching done; DRC passed except solder mask issues; Teardrops not added because pourings don't recognise them
    [msp430.kicad_sch, power.kicad_sch, rx_path_lp_filter.kicad_sch, wulpus_pro_acq_pcb.kicad_pcb, wulpus_pro_acq_pcb.kicad_sch]
2026-04-08 Silkscreen added; Via corrections; BOM corrections; Fabrication files generated
    [host_connector.kicad_sch, hv_mux_tr_sw.kicad_sch, msp430.kicad_sch, power.kicad_sch, rx_path.kicad_sch, rx_path_lp_filter.kicad_sch, tx_path.kicad_sch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]
2026-04-08 Stainless Steel Stiffener version added; Gerbers generated for both PI and Stainless Steel Stiffener versions
    [wulpus_pro_acq_pcb-B_Cu.gbr, wulpus_pro_acq_pcb-B_Mask.gbr, wulpus_pro_acq_pcb-B_Paste.gbr, wulpus_pro_acq_pcb-B_Silkscreen.gbr, wulpus_pro_acq_pcb-Edge_Cuts.gbr, wulpus_pro_acq_pcb-F_Cu.gbr, wulpus_pro_acq_pcb-F_Mask.gbr, wulpus_pro_acq_pcb-F_Paste.gbr]
2026-04-10 Solder mask expansion adjusted to 0mm for IC's and to -0.05mm for other components; Clearance with solder mask expansion set to 0.15mm for all components, PCB modified to comply with the clearance; G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
    [wulpus_pro_acq_pcb-B_Cu.gbr, wulpus_pro_acq_pcb-B_Mask.gbr, wulpus_pro_acq_pcb-B_Paste.gbr, wulpus_pro_acq_pcb-B_Silkscreen.gbr, wulpus_pro_acq_pcb-Edge_Cuts.gbr, wulpus_pro_acq_pcb-F_Cu.gbr, wulpus_pro_acq_pcb-F_Mask.gbr, wulpus_pro_acq_pcb-F_Paste.gbr]
2026-04-13 BOM normalized (components unified under MPN)
    [wulpus_pro_acq_pcb.csv]
2026-04-16 Pouring clearances increased to 0.2mm, pouring minumum width increased to 0.2mm; Gerbers generated
    [wulpus_pro_acq_pcb-B_Cu.gbr, wulpus_pro_acq_pcb-B_Mask.gbr, wulpus_pro_acq_pcb-B_Paste.gbr, wulpus_pro_acq_pcb-B_Silkscreen.gbr, wulpus_pro_acq_pcb-Edge_Cuts.gbr, wulpus_pro_acq_pcb-F_Cu.gbr, wulpus_pro_acq_pcb-F_Mask.gbr, wulpus_pro_acq_pcb-F_Paste.gbr]
2026-04-18 CubeMX migration from nucleo to stm32f303cc; ADC sampling code also migrated (need to double check)
