ikerdcm/wulpus-pro_fpc/(notices)

Notices in the files:
fw/stm32f303cc/Core/Inc/main.h:
Copyright (c) 2026 STMicroelectronics.
All rights reserved.
This software is licensed under terms that can be found in the LICENSE file
parts and their libraries:
COPYRIGHT: Copyright (C) 2021 Ultra Librarian. All rights reserved.
